DurandalCode/star-dome/docs/base-hub.md

# Base hub versions

The base hub (`BASE3-d`, `BASE2-d`) is the one connector that has been printed
and fitted. Its versions are numbered so a printed piece can be traced to the
geometry that made it. A version is a git tag. A version that has been
superseded is frozen, and is not updated
([0006](decisions/0006-a-superseded-design-is-frozen.md)).

| version | tag | stake | what it is |
|---|---|---|---|
| 1.0 | `base-hub-1.0` | steel angle | a stack of flat plates, one channel per level; a pad on the bottom plate and a printed wrap round the angle ([0025](decisions/0025-the-angle-is-met-on-a-pad.md)–[0029](decisions/0029-put-the-lower-stack-bolts-inside-the-base-plate.md)) |
| 1.1 | `base-hub-1.1` | rebar, 8–18 mm | 1.0 with the wrap replaced by a vee cradle on the same pad; the plates are identical ([0031](decisions/0031-the-stake-is-rebar-and-a-vee-takes-any-bar.md)) |
| 2.0 | — | rebar, 8–18 mm | one print: a tube per bow on a rib, a sleeve for the bar ([0032](decisions/0032-the-base-hub-is-one-print.md)); not yet printed |
| 2.0b | — | rebar, 8–18 mm | 2.0 with `ribs = 0`: bare tubes, printed on slicer tree supports. `BASE3-8` 69 cm³ against 2.0's 81; supports to break off, and no rib stiffening the arm. Printed side by side with 2.0 to choose |

`connectors/base_hub_v1.py` is 1.1, and stays 1.1. `connectors/base_hub_v2.py`
is 2.0, and is what the schedule builds.

## What the printed set is for

One `BASE3-8` is printed: plates from 1.0, which 1.1 left unchanged. Its rod
channels are drawn for an 8 mm rod with 1.4 mm of clearance, Ø9.4. In the
hand **a 10 mm composite rebar goes in and an 8 mm one rattles**. The printed
set is therefore a hub for 10 mm composite bows, whatever its name says.
Composite rebar is named by an equivalent diameter and measures differently
across its winding. Until that is measured, the channel says nothing about
the rod named on the part.

## What 1.x taught

The fit check found more than the channel:

- **The stack carries material nobody needs.** Each plate is the full outline
  of the hub. A rod occupies one level, but every other level is solid across
  the same footprint. Seen end on, a printed stack is a block with three holes
  in it.
- **The levels stay.** At a base point the three bows meet at one point in
  one plane ([`weave.base_fan`](../stardome/weave.py)), so the ends *could*
  share a level. They keep the node's levels anyway: a bow should be able to
  pass straight through the foot, and the hub should be able to take that
  bow, so the channels run out both sides. What goes is the material between
  them, not the levels.
- **Five prints per hub is too many** for 10 hubs a dome.
- **The cradle is a short grip**: 40 mm along the bar, and a loose piece to
  hold while two bolts are started.

2.0 starts from those four points.

## The ribs are thin

The rib under each tube is 1.6 mm, four lines of a 0.4 nozzle, rather than
1.5 walls. At 1.5 walls the ribs were about a quarter of the hub: `BASE3-8`
went from 97.5 cm³ to 80.6, `BASE3-10` from 121 to 98. Supports instead of
ribs would save a little more. But they have to be broken off every part,
PETG holds on to them, and the arm loses the stiffness across the fan that a
rib gives. A rib that tall and thin may wobble under the nozzle near its top;
that is one of the things the first print is for.

## 2.0 in the field

1. Drive the rebar.
2. Drop the two M8 nuts into the pockets in the sleeve's tunnel floor.
3. Lower the hub over the bar and do up the two M8 set bolts from below. The
   bolts push the bar into the vee, so any bar from 8 to 18 mm is held.
4. Push each bow end into its tube and pin it.

The bar stands above the foot, past the fan, for the cover's loops to drop
over.

## The ten feet are two prints

Five of the ten base points are the mirror of the other five. Since 2.0 they
take the hub's **mirror image** (`BASE3-8m`, `BASE2-8m`) rather than the hub
turned over, so the rebar sleeve is on the same side of the bundle at all
ten ([0033](decisions/0033-the-base-hub-has-a-mirror-image.md)). Four and
four of `BASE3`, one and one of `BASE2`. Hub 1.x is frozen and is still
turned over.
