DurandalCode/star-dome/docs/roadmap.md

# Дорожная карта

Карта намеренно построена «сначала прототип»: геометрию, сборку и поведение коннекторов нужно доказать на малых вариантах, прежде чем считать XL-варианты строимыми конструкциями.

## Этап 0 — Рабочее место и инструменты

**Цель:** воспроизводимый локальный процесс без платных CAD-сервисов.

- [x] Скелет репозитория.
- [x] Роли инструментов описаны: OpenSCAD / FreeCAD / Blender.
- [x] Инструкции для агентов в `AGENTS.md`.
- [x] Все три инструмента запускаются локально без GUI и управляются из `Makefile`: OpenSCAD 2021.01 (`make scad`), FreeCAD 1.1.3 через `freecadcmd` (`make clamps`), Blender 5.2.1 через `--background` (`make blender`, `make site`). Пути к бинарникам — переменные `OPENSCAD`, `FREECADCMD`, `BLENDER` в начале соответствующих секций `Makefile`.
- [ ] Описать локальную установку под macOS.

**Критерий завершения:** агент может создавать и править геометрию во всех трёх приложениях локально. **Выполнен** — через `Makefile`, а не через MCP.

Про MCP отдельно. Изначально этот этап требовал «подтвердить рабочую настройку MCP» для каждого из трёх приложений, но проект пошёл другим путём, и это оказалось правильным: MCP годится для интерактивного разглядывания, а всё, что должно быть воспроизводимым, запускается скриптом из репозитория. Правило записано в [`architecture.md`](architecture.md): если результат нельзя пересобрать одной командой из чистого клона — это не результат. Поэтому MCP здесь необязателен и в критерий завершения не входит.

## Этап 1 — Эталонная геометрия Star Dome

**Цель:** воспроизвести базовый Star Dome в духе Такэкавы как параметрическую модель.

- [x] Реализовать базовую топологию Star Dome в OpenSCAD.
- [x] Параметризовать диаметр купола и диаметр стержня.
- [x] Сначала получить эталонный вариант D6.
- [x] Определить и назвать дуги, опорные точки и точки пересечения.
- [x] Добавить простые геометрические проверки и производные размеры.
- [x] Получить исследовательские варианты D4, D8 и D12 из той же модели.

**Критерий завершения:** все именованные варианты получаются из одной исходной модели без ручной правки геометрии. **Выполнен.** См. [`dome/README.md`](../dome/README.md).

15 дуг раскладываются на три семейства по 5: семейство G с наклоном `atan(2)` (экваториальные десятиугольники икосододекаэдра, размечаются по пятым долям), семейства U и L с наклонами 79.1877° и 37.3774° (размечаются по третям). В итоге в каждой из 10 опорных точек сходятся 3 конца стержней, а связанных узлов по 4 стержня — 10. Группа симметрии D5.

Два результата важны для следующих этапов:

- **В каждом связанном перекрестье сходятся четыре стержня**, а не два. Коннектор этапа 3 обязан это выдержать, причём на трёх разных углах пересечения. Проверить по фотографиям и физическому макету до проектирования детали.
- **Каждая дуга согнута по радиусу, равному радиусу купола** (от 2000 мм для D4 до 6000 мм для D12), так что минимальный радиус изгиба — прямое ограничение на выбор стержня, а не примечание.

Инженерный отчёт по геометрии генерируется из той же модели скриптом `tools/export_geometry.py` в `exports/geometry/` (JSON + CSV): каждое пересечение стержней с координатами, касательными, углами, наклонами, признаком «сверху/снизу» и классом симметрии. Сам экспортёр геометрии не содержит — источник истины остаётся один.

Диаметры стержней в `configs/variants.toml` остаются предварительными инженерными допущениями. Ничего структурного не проверено.

## Этап 1.5 — Геометрическое ядро и контракт данных

**Цель:** дать этапам 2 и 3 машиночитаемые данные и вынести геометрию туда, где её можно покрыть юнит-тестами.

- [x] Перенести геометрию в Python-пакет без зависимостей, `stardome/`.
- [x] Перенести конфигурацию вариантов в `configs/variants.toml`.
- [x] Выдавать схему `star_dome_geometry/1` как `model.json` плюс плоские CSV-представления.
- [x] Превратить таблицу проверок из `dome/README.md` в исполняемые инварианты (`stardome verify`).
- [x] Закоммитить по одному компактному эталонному срезу на вариант в `tests/golden/`.
- [x] Сверить Python- и OpenSCAD-производители поле за полем.
- [x] Заморозить `dome/star_dome.scad` как эталонную реализацию и гонять сверку в CI на каждом пуше.
- [x] Добавить сборщик сцены `blender/`, читающий `model.json`.
- [x] Добавить генератор зажимов для FreeCAD, читающий `crossing_types`.
- [x] Убрать `configs/variants.scad` в пользу `configs/variants.toml` или генерировать один из другого. Генерируется командой `python3 -m stardome scad-config`, CI падает при любом расхождении — см. `.github/workflows/check.yml`, шаг «Generated config is up to date». `variants.toml` — единственное место, где определяется вариант.

**Критерий завершения:** каждый инструмент ниже по течению читает геометрию из `model.json` и никто её не пересчитывает. **Выполнен.** OpenSCAD, FreeCAD и Blender потребляют сгенерированную модель; никто из них геометрию не пересчитывает.

`dome/star_dome.scad` намеренно продолжает считать свою геометрию сам: в этой независимости и есть вся ценность перекрёстной сверки. Он заморожен, а не превращён в потребителя данных, поэтому базовая топология остаётся под постоянной проверкой двумя реализациями, а вся новая работа идёт только в `stardome/`. См. [`architecture.md`](architecture.md), раздел про политику эталонной реализации.

Зачем этот этап нужен: геометрия здесь аналитическая, а то, что реально требуется этапам 2 и 3 — идентификаторы узлов, касательные, углы пересечения, классы симметрии, выгруженные в JSON, — это ровно то, чего OpenSCAD не умеет без слоя выскребания текста. Два потребителя из трёх и так на Python. См. [`architecture.md`](architecture.md).

Оба производителя совпадают точно на всех вариантах по каждому стержню, узлу, пересечению и полю `meta`. Единственное намеренное расхождение — `crossing_types.family_a`/`family_b` в двух классах L/U, где подписи OpenSCAD-экспортёра и его же колонки углов относятся к разным стержням; вывод Python самосогласован. Генерация коннекторов читает именно эти поля, так что это существенно.

## Этап 2 — Интеграция с Blender и композиция в человеческом масштабе

**Цель:** использовать реальную сгенерированную геометрию для пространственного планирования.

- [x] Выгрузить/загрузить сгенерированную геометрию купола в Blender в масштабе 1:1. `blender/build_scene.py`, `make blender`.
- [x] Сохранить опознаваемость отдельных дуг и пересечений. Объекты несут свои идентификаторы из модели и разложены по коллекциям под роль.
- [x] Добавить переиспользуемые фигуры человеческого масштаба. Фигура 1.75 м, поставлена внутри купола.
- [x] Добавить базовое представление тканевой обшивки. `stardome/cover.py`, `make covers`, см. [`cover.md`](cover.md). Ткань лежит не на номинальной сфере, а на внешней поверхности самого дальнего стержня плетения: у D6 это 3020 мм против 3000, то есть **+1.3% площади**. Плюс раскрой на полотнища: D6 — 13 штук 1460 × 4744 мм на рулоне 1500, 61.7 м швов. Радиус — замкнутая форма `r + 2d`: стопка из четырёх стержней высотой в три диаметра, внешний сидит на 1.5 от номинала, ткань обходит его поверхность ещё на полдиаметра. До 12 сентября здесь стояло 3075 — число из «слоёной» условности, которая разносит 15 дуг по четырнадцати диаметрам, тогда как настоящее плетение укладывается в три. Это было **3.7% лишней ткани на M**.
- [x] Построить процесс проверки габарита входа. `stardome/entrance.py`, `make entrances`, см. [`entrance.md`](entrance.md). Считается, а не прикидывается на глаз: купол разворачивается в координаты «азимут × высота», и наибольший пустой прямоугольник решается точно.
- [x] Построить простой генератор/размещение крытого коридора. `stardome/corridor.py`, `make corridors`, см. [`corridor.md`](corridor.md). Дуговой тоннель на выбранном пролёте, с проверкой того, что все пропускают мимо ушей: **проходит ли коридор в тот проём, к которому пристроен**. Сечение проверяется тем же `doorway.fit_shape`, что и силуэт человека, — одно определение «проходит» на весь проект.
- [x] **Лагерь: купола, соединённые коридорами, по плану из конфига.** `configs/camps.toml`, `stardome/camp.py`, `make camp`, решение 0018, см. [`camp.md`](camp.md). До этого «лагерь» был шеренгой размеров — ни один купол ни с чем не был соединён. План говорит только, какие купола где стоят, насколько повёрнуты и что с чем связано; азимут на соседа, нужная дверь, длина коридора и оба устья выводятся. Дверь наводится **поворотом купола**, а не новым проёмом: купол — жёсткая вещь, которую ставят под углом, а проём стоит прутка и деталей. Чего поворот не может — направить одну дверь на двух соседей; купол в середине лагеря требует двери на соседа, и план об этом сообщает. Дверей и разворота никто не пишет: купол, соединённый с тремя, получает три двери, направленные на этих троих (решение 0019). И там же вылезло ограничение, про которое никто не говорил вслух: **дверь стоит в пролёте, а их пять через 72°**, поэтому азимут и обратный ему (разница 180°, не кратная 72) не могут оба попасть на двери у двух одинаково поставленных куполов. Один из пары приходится развернуть на 36° — и выведенные развороты сами ложатся чередованием 0/36 вдоль каждого коридора. Поставляемый `tree` — семь куполов, шесть коридоров, все шесть садятся точно на двери с обоих концов.
- [x] Создать композиционную сцену с несколькими экземплярами. `blender/build_site.py`, `make site` для всех шести вариантов и `make sizes` для четырёх именованных — каждый развёрнут дверным проёмом к камере, с фигурой 1.75 м в этом проёме.
- [x] Дверей у купола может быть несколько, и каждая смотрит куда сказано. `[[variants.X.doors]]` в `configs/variants.toml`, решение 0016. Направление задаётся азимутом и является пожеланием: дверь может стоять только в пролёте, их десять, и подходящие зависят от реза — портал в низком, всё остальное в высоком. Двери не независимы: рез убирает пруток из габаритной огибающей по всему куполу, поэтому каждый проём меряется уже на куполе со всеми резами. Старая пара `door`/`door_cut` продолжает означать одну дверь и даёт побайтово тот же результат.
- [x] Выбрать и отрисовать сам дверной проём. `stardome/doorway.py`, `make doorways`, см. [`doorway.md`](doorway.md). Не просто «дверь куда-то влезает», а какой пролёт, какими стержнями и каким узлом он обрамлён, выгруженный замкнутым 3D-контуром, который рисуют сборщики сцены.

**Критерий завершения:** входы и коридоры можно расположить относительно реальной раскладки стержней и осмотреть с высоты человеческих глаз.

**И результат по интерьеру меняет то, какой вариант строить.** Комнату определяет не диаметр и не высота в коньке, а **сколько квадратных метров пола, на которых можно встать в полный рост**, — и голый купол тратит большую их часть впустую: у D4 12.6 м² пола и 2.4 м², где можно выпрямиться, то есть 19%. Юбка — самое дешёвое лекарство с большим отрывом: D3 на метровой юбке даёт больше чем вдвое больше места в рост, чем голый D4, на меньшем пятне и меньшем метраже стержня. Вся цена — ветер: индекс опрокидывания 0.424 для голого купола любого размера и растёт до 0.74 у D3 с метровой юбкой. **D6 + 760 мм юбки** поднимает долю полезного пола с 64% до 88%, и на тот момент это выглядело как ответ для эталонного прототипа. Дверной проём ниже это отменил: юбка перестала быть нужна для входа, осталась только ради площади, и M строится голым. См. [`interior.md`](interior.md).

**Результат по входу меняет вопрос о размере.** Самое высокое место без препятствий у опорного кольца — 0.2549 × диаметр, и доля одна и та же для любого варианта, потому что топология фиксирована. Значит, двери в рост не существует ниже D10: лучший проём D6 — 497 мм шириной на высоте 1200 мм, а у D3 и D4 проёма высотой 1200 мм нет вообще. Двери 1800 × 700 мм нужно 760 мм юбки на D6, 1320 мм на D4 и 1600 мм на D3 — что для D3 означает конструкцию 3.07 м над пятном 3 м. По прямоугольнику выходило, что D6 просит юбку, а D3 — вход ползком или другой размер. См. [`entrance.md`](entrance.md).

**А результат по дверному проёму снова всё смягчает.** Те цифры вписывают *прямоугольник*, а ни человек, ни проём прямоугольником не являются. Каждый из пяти высоких пролётов — стрельчатая арка: две дуги G, сходящиеся в связанном четырёхстержневом узле, с опорами в двух опорных точках. Вписать силуэт формы человека в отверстие формы человека дешевле, чем говорил прямоугольник: 1240 мм на D4 вместо 1320, 700 на D6 вместо 760, 190 на D8 и ноль на D10. Проём не стоит ничего — ни реза стержня, ни выдуманного соединения, — и таких пролётов пять. См. [`doorway.md`](doorway.md).

**И наконец портал отменяет остаток вопроса.** Дверь уехала из высокого пролёта в низкий — два U и одна почти горизонтальная L сверху, — и туда она встаёт за 2.8% стержня, не перерезав ни одной дуги. После этого юбка для входа не нужна нигде.

**Размеры устоялись как S = D4 + 1350 мм, M = D6 без юбки, L = D8 без юбки, XL = D10 без юбки, XXL = D12 без юбки.** Все кроме S голые по выбору, и юбка у S стоит не ради двери, а ради площади пола. Входят все:

| | просвет | пропускает |
|---|---|---|
| S | 1210 мм над юбкой | всё, включая персонажа 2.2 м |
| M | 1816 мм | с ношей, но не 800 мм в ширину и не 2.2 м в рост |
| L | 2423 мм | всё, включая персонажа 2.2 м |
| XL | 3029 мм | всё, с запасом |
| XXL | 3636 мм | всё, с запасом |

**Имя размера говорит, что выбрана сборка, а не что стержень проверен под нагрузкой.** Ни один размер в этой семье под нагрузкой не считался: `stardome span` сравнивает купола друг с другом и принимает пригодность эталона как данность — это этапы 3 и 8. Громче всего это допущение звучит на XXL: равный прогиб на пролёте 6283 мм просит 40 мм стержня против заложенных 12. Поэтому `note` у D12 это и говорит, и он единственный, кому приходится.

**M — единственный из построенных размеров, который кому-то отказывает.** Поле `door` в конфиге фиксирует, что купол реально пропускает, а не что хотелось бы, и модель перечисляет каждый силуэт, который проходит.

## Этап 3 — Первый печатный коннектор перекрестья

**Цель:** заменить верёвку/вязку в характерном перекрестье быстрым переиспользуемым печатным коннектором.

- [x] Выбрать эталонные диаметры стеклопластикового стержня, изначально 8 и/или 10 мм. Зафиксировано в `configs/variants.toml`: 8 мм для D3/D4, 10 мм для D6/D8, 12 мм для D10/D12; эталонный прототип D6 — 10 мм. Это выбор, а не измерение: подтверждение по реальному прутку — следующий пункт, и он открыт.
- [ ] Измерить реальный допуск стержня и поведение поверхности. **Модель к этому готова.** В РФ самый вероятный пруток — композитная стеклопластиковая арматура (ГОСТ 31938), бухтами по 50 м, ~42 ₽/м. Она названа по **эквивалентному** диаметру, а несёт навивку, которая стоит выше него: канал, прорезанный по имени, стержень не примет. Поэтому одно число разделено на два — `rod_diameter` остаётся стержнем как **несущим элементом** (от него болт, длина муфты, оценка изгиба), а `rod_outer_diameter` описывает стержень как **предмет, который должен пролезть** (каналы, контакт стержня о стержень в узле, радиальный шаг плетения, габарит проёма, сфера, на которой лежит ткань). По умолчанию ноль — значит, совпадают. Останется подставить замеренное.

  Чувствительность посчитана: при наружном от 10 до 12 мм плетение решается всюду, ткань растёт на 0.2%, высота стопки узла — на 15%, габарит зажима — на 2 мм. **Геометрия устойчива; ломается только посадка.** Заодно бухта мотается на диаметр 1.2 м при нужных дуге 3 м радиуса — первое подтверждение со стороны материала, что радиус изгиба не проблема.
- [x] Спроектировать зажим перекрестья во FreeCAD. V1, двухсоставный на болтах, см. [`crossing-clamp-v1.md`](crossing-clamp-v1.md).
- [x] Избежать острых кромок контакта и точечной нагрузки на стеклопластик. Раструбы на входах, сёдла 180°; контакт «стержень по стержню» в перекрестье ещё предстоит подтвердить.
- [x] Сделать параметрическими зазор, диаметр стержня, толщину стенки и размеры крепежа. Варианты 8/10/12 мм получаются из одного набора параметров.
- [ ] Напечатать и проверить многократную сборку-разборку. **Появилось что проверять помимо самой печати.** У зажима теперь два варианта закрытия — `fastenerStyle`, решение 0020, см. [`quick-release.md`](quick-release.md): болтовой V1 без изменений и навесной, где крышка сидит на стальном штифте в плоскости разъёма, а болт остаётся один и стоит в пазу, открытом наружу. Купол M просит **84 болта в поле**, а в мастерской с хабом 2.0 не остаётся ни одного, и навесной вариант убирает из полевых 32. Чего никто не мерил: держит ли один болт то, что держали два (второй узел теперь работает на срез штифта, а не на растяжение болта), и сколько циклов выдержит печатная проушина — 2.85 мм материала вокруг отверстия. Оба вопроса — на стенд, и до ответа умолчанием остаётся болтовой.
- [ ] Зафиксировать режимы отказа и переделать.
- [x] Согласовать зажим со сгенерированной геометрией перекрестья. `connectors/generate_clamps.py` читает расписание, которое `stardome` выводит из модели, и строит каждую деталь на её настоящем угле пересечения и диаметре стержня — он не считает никакой геометрии купола сам.

**Геометрические ограничения, которым обязан соответствовать коннектор.** Из модели этапа 1:

- Точек пересечения **40**, а не 20: 10, где через одну точку проходят **четыре** стержня, и 30, где два. Зажим V1 — деталь на два стержня.
- Контактов «стержень-стержень» **90**, в **12 симметрично различных геометриях**, на **пяти разных углах пересечения**: 37.3774, 41.8103, 63.4349, 70.5288 и 79.1877°. Деталь, предполагающая один угол, не подойдёт.
- 60 связанных контактов используют четыре из этих углов; все 30 несвязанных — на 70.5288° = `acos(1/3)`.
- Наклон стержня в перекрестье меняется от 4.7 до 65.4° над горизонтом, так что зажим не может рассчитывать, что пара стержней лежит в удобной плоскости.

**Четырёхстержневой узел подтверждён.** Это была реконструкция; теперь она сверена с монтажной схемой самого первоисточника. На панели 1 обвязаны 5 стыков синей пентаграммы, в каждом пересекаются две синие дуги; на панели 2 добавлены зелёные дуги, и те же 5 обвязок держат две синие плюс две зелёные. Четыре стержня, в том рисунке, который предсказывает модель. См. [`tied-node.md`](tied-node.md) и [`references.md`](references.md).

Но два момента тот же источник меняет:

- Первоисточник **вяжет эти стыки попарно**, двумя-тремя стяжками, собранными на коротком участке, а не как один пучок из четырёх стержней. Жёсткая веерная деталь — отход от его практики, так что короткая стопка двухстержневых зажимов остаётся законной альтернативой, и притом сохраняющей одно семейство деталей.
- В бамбуковой модели обвязок **намного больше, чем десять размеченных**. То есть авторитет первоисточника не даёт оснований отказаться от 30 двухстержневых зажимов; это решение за прототипом D4.

**Что говорит расписание коннекторов.** `python3 -m stardome connectors D6` раскладывает каждое пересечение по детали, которая его обслужит. На сегодня для D6 это шесть типов деталей, 107 штук на купол:

| деталь | шт. | генератор |
|---|---|---|
| `FAN4-10-37.3774` — веер на 4 стержня | 10 | `fan_node_v2` |
| `CL2-10-70.5288` — зажим на 2 стержня | 30 | `crossing_clamp_v1`, в двух зеркальных исполнениях 17/13 |
| `BASE3-10` — опорный хаб на 3 конца | 8 | `base_hub_v2` |
| `STAKE-BASE` — забивная стальная арматура | 10 | железка, её надо выбрать, а не проектировать |
| `BASE2-10` — пятка косяка, 2 конца дуги | 2 | `base_hub_v2` |
| `TERM-10-70.5288` — окончание разрезанной дуги | 2 | `term_clamp_v1` |
| `SPLICE-10` — стык дуги по длине | 45 | `rod_splice_v1` |

**97 деталей из 107 генерируются, 10 — покупная железка, недостающих нет.** Пробел закрыт. Осталась одна вещь, и она не деталь: забивной стальной уголок надо выбрать по размеру, а не спроектировать.

Три исправления всплыли только тогда, когда деталь впервые попробовали поставить на купол (`make assembly`):

- **Опоры по краям проёма держат два конца дуги, а не три.** Разрез портала снимает `L1` с `b0` и `L4` с `b1` — ровно с тех двух опор, между которыми стоит дверь. Расписание по-прежнему просило десять одинаковых трёхлучевых хабов. Теперь просит восемь плюс два `BASE2`: те же дуги U и G, зазор 37.3774° в обоих случаях, зеркальная пара — то есть одна печать. Ни в расписании, ни здесь этого раньше не было.
- **Веер резался не по тому лучу.** Порядок лучей брался сортировкой по углу, а первым считался наименьший. У пяти нижних узлов при этом самый широкий зазор попадает в **середину** стопки, и они требуют каналов с шагом 37.3774, 63.4349, 37.3774°, тогда как у напечатанной детали шаг 37.3774, 41.8103, 37.3774°. Десять узлов, две детали — при том что проект всегда утверждал, что деталь одна. Разрез по самому широкому зазору делает утверждение верным, и решённая намотка на нём остаётся допустимой.
- **Двухстержневой зажим — хиральная деталь.** Крышка идёт снаружи, поверх стержня, который идёт снаружи, поэтому перевернуть её, чтобы сошлись углы, нельзя: 17 перекрестий берут деталь как нарисована, 13 — её зеркало. Это вторая печать, которую никто не считал.

- [ ] Решить, нужны ли 30 несвязанным пересечениям зажимы вообще, или усилия целиком принадлежат четырёхстержневым узлам. **Цена вопроса посчитана: 5/3 по пролёту и 2.78× по диаметру прутка** (`make spans`, см. [`span.md`](span.md)). Без зажимов дуга держится только за пятки и метки, и наибольший пролёт в куполе — 60° на семействах U и L; с зажимами он падает до 36° на G, а U и L уходят на 22.24°. Семейство G не выигрывает ничего: все четыре его пересечения и так связанные узлы. Решение по-прежнему за образцами, но теперь известно, чем платить за «нет».
- [x] Выбрать радиальный порядок укладки в четырёхстержневом узле. **Веерный порядок, 1-2-3-4.** См. [`tied-node.md`](tied-node.md).
- [x] Проверить, согласуется ли одно глобальное назначение «сверху/снизу» на всех 90 контактах сразу. **Согласуется**, для любого порядка укладки, и не требует радиального места сверх собственной высоты стопки.
- [x] Спроектировать веерный коннектор на четыре стержня. **V2** в `connectors/fan_node_v2.py`, см. [`fan-node-v2.md`](fan-node-v2.md): стопка из пяти плит, каждый стержень в настоящем канале, контакта «стержень по стержню» нет. Шаг стопки 10.00 мм: стержни опираются друг на друга в перекрестье, а каждая плита — крест с отверстием посередине, так что стопка ровно такой же высоты, как у V1, но каждый стержень лежит в канале. Все пять печатаются без поддержек. V1 ([`fan-node-v1.md`](fan-node-v1.md)) зажимал стержни пучком и средние два не фиксировал вовсе; оставлен как запись. В пластике ничего не проверено.
- [ ] Выбрать между веерной деталью и стопкой двухстержневых зажимов — по напечатанным образцам.

**Четырёхстержневой узел оказался лёгким случаем.** Все четыре стержня в связанном узле компланарны — касательная к большой окружности лежит в касательной плоскости сферы, — так что узел это плоский четырёхлучевой веер со стержнями, уложенными по радиусу, а не трёхмерный клубок. Все десять узлов — один и тот же веер: зазоры 37.3774, 41.8103, 37.3774 и 63.4349°, в сумме 180. Пять верхних узлов читаются как G-U-U-G, пять нижних как L-G-G-L, но геометрически это одна форма.

Значит, всему куполу нужны **две геометрии коннектора**: один веер на четыре стержня (10 шт.) и один зажим на два (30 шт., и необязательный). Не двенадцать.

Порядок укладки выбран веерный, 1-2-3-4: он выводит три самых пологих угла в контакт «стержень по стержню», требует двух различных углов седла вместо трёх, палиндромен и формулируется в поле одной фразой. Его цена в том, что стержни G и L меняют уровень между узлами, что выражается уклоном 1.6% — не ограничение. Высота стопки — три диаметра стержня.

**Плетение сходится.** Если вести стержни прямо между их смещениями в связанных узлах, 15 из 30 несвязанных пересечений начинают проникать друг в друга, то есть наивный ответ неверен, — но согласованный маршрут существует, для любого порядка укладки, и он остаётся внутри радиальной полосы, которую и так занимает четырёхстержневая стопка (±1.5 диаметра стержня). Стержень сходит со своей большой окружности примерно на градус. С ростом купола плетение становится проще, так что **тесный случай — D4, а не D12**.

Одно следствие для детали: стержень приходит в узел с радиальным наклоном до ~1.2°, вообще говоря разным с каждой стороны, так что канал, просверленный строго по касательной, создаст в нём предварительное напряжение.

**Критерий завершения:** один коннектор можно многократно собирать в поле, не повреждая стержень и не требуя возни с крепежом.

## Этап 4 — Физический прототип D4/D6

**Цель:** проверить базовую систему до масштабирования вверх.

- [ ] Собрать частичный полноразмерный макет звезды/перекрестья.
- [ ] Собрать полный каркас D4 или D6.
- [ ] Замерить время сборки и размер бригады.
- [ ] Проверить повторяемость формы и подвижность коннекторов под нагрузкой.
- [ ] Проверить посадку обшивки и размещение входа.
- [ ] Проверить концепцию удержания/анкеровки основания в контролируемых условиях.
- [ ] Вернуть измеренную геометрию и найденные проблемы обратно в CAD.

**Критерий завершения:** малый/эталонный купол собирается, накрывается, разбирается и пересобирается предсказуемо.

**Бюджет допусков посчитан, и он меняет способ разметки, а не аккуратность.** Измеряется во всей конструкции ровно три вещи: 10 колышков, 15 длин и 40 меток — остальные 30 пересечений не размечает никто, они ложатся туда, куда их выводит плетение. См. [`tolerance.md`](tolerance.md) и `python3 -m stardome tolerance D6`.

- **Форма ошибку гасит, а не усиливает.** Две точные производные, не зависящие от размера купола: подъём дуги меняется на **+1/2** мм на миллиметр длины стержня и на **−(π/4 − ½) = −0.2854** мм на миллиметр диаметра основания. Обе по модулю меньше единицы.
- **Общая ошибка бесплатна; платят только расхождения.** Если все дуги длиннее на 10 мм и кольцо шире на 10 мм, купол просто получается другим и сходится сам с собой — метки берутся долями от собственной длины стержня. Смотреть надо не на высоту, а на **разброс в узле**: насколько разошлись четыре метки, которые должны были совпасть.
- **Вопрос не в том, каков разброс, а в том, чем его мерить.** Разброс `s`, натянутый на пролёт `a`, гнёт стержень по параболе с кривизной `2s/a²`; стержень и так согнут по радиусу купола, поэтому честная мера — доля от той кривизны, которую он уже держит. Чистая геометрия, без модуля и прочности. Пролёт берётся из схемы разметки: стержень удерживается на ногах и на метках и больше нигде — 30 несвязанных пересечений не зажимы. Пятые доли семейства G дают самый тесный пролёт и задают допуск.
- **Держать нужно порядка одной 215-й радиуса, и этого достигает рулетка.** ±7 мм на D3, ±14 мм на D6, ±27 мм на D12 для колышков и меток; на длине реза вдвое свободнее. Допуск **пропорционален куполу**, а не абсолютен: допустимый разброс это `бюджет × пролёт² / 2R`, а пролёт растёт вместе с R. Все размеры одинаково требовательны в относительных единицах.
- **Небрежная сборка проходит.** Рулетка по траве без особой аккуратности (сигмы 10/3/3 мм) даёт медианный разброс в узле 32 мм, то есть **5.4% добавки к кривизне**, 7.5% на p95 и около 10% в худшем прогоне из двух тысяч.

Практический итог: **шаблон не нужен, рулетки достаточно.** Единственное правило, которое стоит соблюдать, потому что оно бесплатное: **все метки отмерять от одного конца стержня** — разметка «от предыдущей» стоит на 54% больше разброса при той же аккуратности, так как четвёртая метка дуги G несёт четыре ошибки вместо одной.

Оговорка, которая здесь важнее вывода: `2s/a²` считает соседние узлы жёсткими, то есть это верхняя оценка, а «10% добавочной кривизны» — выбранный бюджет, а не предел. Где предел на самом деле, скажет прочность реального прутка. Это ровно тот открытый пункт этапа 3, который ни от чего не зависит, и теперь он упирается ещё и сюда.

**Порядок сборки посчитан заранее, и ни одного пункта выше он не закрывает** — все они про физику. Но идти в поле, не зная, в каком порядке ставить дуги, больше не нужно. Плетение — это орграф на 15 вершинах с 90 дугами «внутренний → внешний», порядок сборки — его линейное упорядочение, а цена порядка — число дуг, направленных назад, то есть минимальное разрезающее множество дуг. При 15 вершинах оно решается точно. См. [`assembly.md`](assembly.md) и `python3 -m stardome assembly D6`.

Три результата меняют то, как планировать этап:

- **Сборки без протаскиваний не существует.** Плетение циклично: G1 внутри G5, G5 внутри U1, U1 внутри G1. Три дуги, каждая внутри следующей, в линию не выстраиваются. Это не дефект — ациклическое плетение было бы стопкой обручей, которую ничто не держит.
- **Минимум — 20 протаскиваний из 90 пересечений, и он одинаков для всех вариантов.** Орграф задаётся топологией и порядком укладки в узле, а они не масштабируются. **D3 и D12 — это одна и та же сборка**; с размером меняется длина и вес того, что пружинишь, а не сколько раз. Так что малые варианты не «те, которые проще поставить».
- **18 из 20 куплены в десяти связанных узлах.** Веерный порядок ориентирует 60 дуг из 90 ещё до всякого плетения, и одни они уже стоят 18. Значит, маршрут 30 свободных пересечений почти ничего не стоит, а дешевле собрать можно только через другой порядок укладки — см. `weave.stacking_options`.

Для поля важно ещё одно: порядок «по семействам», который единственный можно произнести вслух, стоит 30 против 20, и делится ровно одним правилом — **семейство L поднимать раньше U**. Где идёт G, не имеет значения. Стоят ли 10 лишних протаскиваний того, чтобы не сверяться со списком из 15 пунктов, решает секундомер этого этапа, а не геометрия.

## Этап 5 — Семейство коннекторов и интерфейсы

**Цель:** сохранить простоту полевой сборки при полноценной временной конструкции.

- [x] Опорный/грунтовый коннектор. `connectors/base_hub_v1.py`, см. расписание выше (`BASE3-10`): плоский веер из трёх лучей, арматура прижимается к площадке отдельным ложементом с V-пазом, который берёт любой пруток от 8 до 18 мм ([решение 0031](decisions/0031-the-stake-is-rebar-and-a-vee-takes-any-bar.md)); четыре болта стягивают стопку плит. Спроектирован и генерируется из модели. Первый `BASE3-8` напечатан: в канал входит композитная арматура 10, а 8 болтается — записано в [`printing.md`](printing.md), пока не исправлено. Версии хаба — [`base-hub.md`](base-hub.md): 1.0 под уголок, 1.1 под арматуру, напечатанный комплект фактически под композитную арматуру 10. **2.0** (`connectors/base_hub_v2.py`, [решение 0032](decisions/0032-the-base-hub-is-one-print.md)) — одна печать вместо пяти: трубка на ребре под каждую дугу на прежних уровнях, гильза 80 мм под арматуру 8–18 мм, без стяжных болтов; `BASE3-8` — 98 см³ вместо 222. Ещё не напечатан.
- [x] Семейство перекрёстных коннекторов под выбранные размеры стержня. Две геометрии — веер на четыре стержня и зажим на два, — обе параметрические по 8/10/12 мм из одного набора параметров. Спроектированы и генерируются; **в пластике не проверены**.
- [x] Соединения юбки. `connectors/skirt_collar_v1.py`, решение 0017, см. [`skirt.md`](skirt.md). Раньше расписание читало опорную точку с юбкой как **восемь членов** — три конца дуг, голова стойки, две хорды кольца и две головы раскосов, — и это был самый нагруженный узел конструкции без единой детали. Ничего из этого не обязано было быть правдой: у хаба уже есть площадка и болт под забивной уголок (до решения 0025 — сквозной паз), а **стойка юбки — это тот же уголок, только длиннее**. Значит купол с юбкой берёт ровно тот же `BASE3`, что и голый, а собственные члены юбки садятся на хомут, зажатый на стойке. У верха и низа стойки хомут один и тот же: хорды уходят горизонтально на обоих концах, раскосы — под одним углом, вниз у головы и вверх у пятки, так что перевёрнутая через наружный радиус головная деталь и есть пяточная. Одна геометрия, 20 штук на купол. Типов деталей без чертежа стало 1 вместо 3.
- [ ] Крепление пояса/растянутого элемента.
- [x] Крепление обшивки, не концентрирующее нагрузку на одной печатной детали. `stardome/attachment.py`, `make attachment`. Способ удовлетворить требование оказался не «лучше проушина», а **никакой проушины**: обшивка садится на те же забитые уголки, на которых стоит сам купол — единственное, чья работа и так держать конструкцию от подъёма. Три части: болт-роуп в подрубке по всей кромке основания (линия в кулиске, а не ряд люверсов — ткань рвётся от точки и не рвётся от линии), десять петель по опорам, и пять лент через макушку по дугам семейства U. Ленту по дуге не надо никуда крепить отдельно: дуга и так идёт от опоры до опоры. Все три семейства касаются каждой опоры ровно по разу, а U — единственное, что доходит до верха (2947 мм против 2683 у G и 1821 у L). Итого на M: 17.2 м троса, 50.4 м ленты, 10 анкеров, **ноль печатных деталей**. См. [решение 0014](decisions/0014-the-cover-hangs-on-the-stakes.md). Нагрузку никто не считал — это этап 8.
- [ ] Интерфейсный коннектор входа/коридора. Стало нужнее: у купола теперь может быть несколько дверей в разные стороны, и коридор цепляется к первой из них.
- [x] Крепёж выводится из прутка, а не стоит константой. `connectors/kit.py`, `FASTENERS` и `scale_to_rod`: болт — половина диаметра прутка, округлённая до ближайшего из M3/M4/M5/M6/M8, стенка `0.4 × пруток` с полом 3 мм, поперечный штифт `0.4 × пруток` по стандартным размерам. Раньше везде стоял M5 независимо от прутка, из-за чего зажим выходил **8.1 × прутка** на 6 мм и **3.8 ×** на 16 мм, а опорный хаб был 113 мм поперёк при любом диаметре вообще. Теперь зажим 5.3 ×, веер 6.4 × на 10, 12 и 16 мм. Правило подобрано так, чтобы на 10 мм получался M5: **все 17 печатных деталей M не сдвинулись ни на микрон**, изменились только 8- и 12-мм. Это соглашение, а не расчёт — силу здесь никто не считает. См. [решение 0013](decisions/0013-the-bolt-is-half-the-rod.md).
- [ ] Перемычка над дверью (`HDR`) — единственная позиция в любом расписании, за которой не стоит ничего. Зажимает перемычку к дуге посередине пролёта, где нет пересечения, и уносит обруч верхнего кольца в обход проёма.
- [ ] Система маркировки или ключей для полевой сборки. Заготовка есть: у деталей осмысленные идентификаторы (`FAN4-10-37.3774`, `CL2-10-70.5288`, `BASE3-10`), а плиты стопки названы по позиции (`Bottom`, `Mid1`, `Mid2`, `Mid3`, `Cap`). Чего нет — физической маркировки на детали и защиты от сборки не в том порядке.
- [x] Стык дуги по длине (`SPLICE`, 45 шт. на D6). `connectors/rod_splice_v2.py` — **ферула**: трубка, в которую секции вдвигаются с двух концов, как в палаточной дуге. Стык — единственное соединение в куполе, которому не надо смыкаться вокруг чего-либо, потому что до сборки секции это два отдельных предмета. Длина 10 диаметров стержня, по 5 на сторону; держат два поперечных штифта, болтов нет. Прямая, а не гнутая: пруток на сборке ещё прямой, гнут его уже с надетой ферулой. **Середина расточена**, иначе жёсткая трубка длиной 100 мм заставила бы дугу выпрямиться на своей длине; так она опирается на два конца, а дуга изгибается внутри неё. Места стыков считает `stardome`, и считает их **на весь купол сразу**: купол режется не более чем на **две длины** — раскладка подбирается так, чтобы ни одна секция не была длиннее транспортной, ни один стык не сел на перекрестье, а в мешке лежало два типоразмера, а не четыре (на D12 — семь). M и XL от этого не сдвинулись, S и L стоили нуля лишних стыков. См. [решение 0024](decisions/0024-a-dome-is-cut-into-two-lengths.md).

  Цена ошибки, которую это исправило: V1 была двухсоставным зажимом на болтах — архитектура зажима перекрестья, скопированная туда, где она не нужна. Вышло 48.4 мм в ширину на 10-мм стержень, **3.54 л пластика и 180 болтов M5 на купол** против 0.74 л и нуля. `rod_splice_v1.py` заморожен как запись.

  **В пластике не проверено, и держит ли оно изгиб — вопрос стенда.** Отдельно: для FDM это плохая деталь — печатать стоймя значит положить слои поперёк оси, то есть ровно в ту плоскость, которую изгиб и раскрывает. Ферула — первый кандидат на то, чтобы её **купить**: 45 штук это 4.5 м трубки Ø18×4.
- [x] Окончание разрезанной дуги (`TERM`, 2 шт.). `connectors/term_clamp_v1.py`: это зажим перекрестья с одним закрытым каналом, собранный поверх `crossing_clamp_v1`, а не второй такой же файл. Узлы `N26` и `N25` на M, оба под 70.5288°. **Это единственное место в куполе, где нагрузка приходит вдоль стержня в печатный пластик** — торец дуги упирается в стенку 5 мм. Хватает ли её — вопрос стенда.
- [x] Пятка косяка (`BASE2`, 2 шт.). Тот же генератор опорного хаба с одним лучом меньше.

**Критерий завершения:** конструкции хватает небольшого понятного семейства повторяющихся печатных деталей. **Выполнен геометрически:** шесть типов, 97 деталей на купол M, плюс десять покупных прутков арматуры. Не выполнен физически: в пластике не проверено ничего.

## Этап 6 — Большой вариант D8

**Цель:** нащупать практический верхний предел почти классической системы Star Dome.

- [ ] Выбрать размер стержня/трубы по измеренному поведению прототипа, а не простым геометрическим масштабированием. **Первая проверка нынешних значений сделана, и она их не подтверждает.** `configs/variants.toml` прямо называет свои диаметры допущениями; подобие просит `d ~ R`, а начиная с D8 каждый вариант тоньше этого: D8 несёт 10 мм там, где подобие просит 13.3, D12 — 12 мм против 20. По прогибу между опорами D12 в 11 раз слабее D6, из которого выведен.

  **Вторая проверка, уже с материалом, говорит обратное — и это не противоречие.** По допускаемой деформации гибки (`strength.md`) запас, наоборот, растёт с куполом: 0.45 на D12 против 1.19 на D3. Две проверки отвечают на разные вопросы. Подобие спрашивает «одинаково ли прогибается» и наказывает тонкий пруток на большом куполе; ползучесть спрашивает «переживёт ли пруток то, что его согнули» и наказывает толстый пруток на малом радиусе. Первое — про жёсткость, второе — про то, сломается ли бар. Выбирать диаметр придётся между ними, и D8 остаётся тем местом, где обе сходятся: 8.1 м — потолок семейства по паритету собственного веса при настоящей допускаемой деформации.
- [x] Проанализировать свободные пролёты. `stardome/span.py`, `make spans`, см. [`span.md`](span.md). Наибольший пролёт — **1.0472 R**, то есть 60° дуги, одинаково на каждом варианте: топология подобна себе в любом размере, поэтому пролёт это свойство не диаметра, а решётки. На D8 это 4189 мм, на D12 — 6283. Деформации остаются: по подобию считается **отношение** прогиба к эталонному D6 (неизвестная константа перед `w a⁴/EI` одинакова у двух домов одной формы и сокращается), но абсолютный прогиб требует модуля и нагрузки — этап 8.
- [ ] Оценить нижний периметральный пояс натяжения. Мерка задана решением 0015: пояс по периметру не ставит опору в середину дуги, значит потолка размера он не двигает вообще — он отвечает на другой отказ (распор пяток), и оценивать его надо по нему.
- [ ] Оценить один дополнительный кольцевой стабилизирующий пояс. Это первый кандидат, который пролёт действительно режет. Посчитано заранее: **один пояс и два пояса не сдвигают наибольший пролёт вообще** — у семейства G пять пролётов по 36°, а горизонтальное кольцо режет дугу ровно в двух точках, так что до трёх поясов один пролёт всегда остаётся целым.
- [ ] Проверить стратегию анкеровки и пути передачи нагрузки от обшивки.
- [ ] Строить только после того, как структурные допущения проверены и испытаны надлежащим образом.

**Критерий завершения:** определить, жизнеспособен ли D8 на базовой топологии плюс минимальном повторяющемся усилении.

## Этап 7 — Исследование XL-топологии: D10–D12

**Цель:** выяснить, насколько далеко масштабируется идея быстрой сборки, не притворяясь, что базовая конструкция масштабируется напрямую.

Кандидатные стратегии усиления для сравнения:

- периметральное кольцо/пояс натяжения;
- один или несколько кольцевых стабилизирующих поясов;
- дополнительные повторяющиеся усиливающие дуги;
- более плотная вторичная решётка Star Dome;
- частичная двойная решётка;
- стеклопластиковая труба вместо сплошного стержня;
- выделенный каркас входа/коридора;
- распределённая обвязка обшивки, передающая ветровые нагрузки на анкеры.

Для каждого кандидата сравнить:

- количество деталей;
- количество уникальных типов деталей;
- количество действий при полевой сборке;
- время сборки;
- транспортный объём/длину;
- наибольший неподкреплённый пролёт;
- вероятные режимы отказа;
- требования к анкеровке;
- взаимодействие со входами и коридорами.

**Критерий завершения:** выбрать одну XL-концепцию, достойную детальной инженерной проработки, либо установить практический потолок размера ниже 10–12 м.

### Мерка выбрана, и она одна

Девять критериев выше — это то, во что кандидат обходится. Сначала он должен пройти один: **что он делает с наибольшим неподкреплённым пролётом.** Решение 0015, `stardome/span.py`, [`span.md`](span.md).

Причина — пара показателей степени. Чтобы держать прогиб эталонного купола, пруток должен быть **не тоньше** `d₀(a/a₀)²`; чтобы его вообще можно было согнуть по радиусу купола, он должен быть **не толще** `2Re`. Первое растёт как квадрат пролёта, второе — только как радиус. Они пересекаются ровно один раз, и это пересечение и есть потолок семейства:

| допускаемая деформация | 0.2% | 0.4% | 0.6% | 0.8% |
|---|---|---|---|---|
| наибольший купол, паритет по собственному весу | **7.2 м** | 14.4 м | 21.6 м | 28.8 м |

Пролёт входит в квадрате, поэтому **вдвое короче пролёт — вчетверо выше потолок.** Больше ничто в списке кандидатов его не двигает.

Что уже известно про сам список:

- **пролёт одинаков на всех вариантах** — 1.0472 R, то есть 60° дуги. Это свойство решётки, а не диаметра, поэтому «D12 слишком большой» — утверждение не про D12;
- **периметральное кольцо, обвязка обшивки и труба вместо прутка опоры в середину дуги не ставят.** Они отвечают на другие отказы — распор пяток, отрыв ткани, масса — и потолка не двигают вовсе. Их место в сравнении — после того, как кандидат прошёл мерку, а не вместо неё;
- **одного и двух кольцевых поясов не хватает.** У семейства G пять пролётов по 36°, горизонтальное кольцо пересекает дугу ровно дважды, поэтому до трёх поясов хотя бы один пролёт остаётся целым и наибольший не сдвигается ни на градус. Три пояса опускают его до 22.24° — и упираются в семейство L, которое высокие пояса не достают;
- **на XL рез двери перестаёт быть обязательным.** Нерезаный высокий пролёт впускает `walk` с D 8063, `carry` с D 8656 и 2.2-метрового персонажа с D 9848, так что на D10 и D12 рез покупает ширину и высоту, а не проход — ценой двух лишних типов деталей (`BASE2` и `TERM`, причём про `TERM` расчёт не говорит ничего). Решение 0007 ставило дверь порталом в низкий пролёт и было право на D6, где рез — разница между «согнувшись» и «войти»; на XL эта посылка не держится. См. [`doorway.md`](doorway.md);
- **потолок задаёт не топология.** Он задан одним числом, которого нет ни у кого: допускаемой деформацией прутка. При 0.2% потолок ниже D8, при 0.4% — за D12. Это ровно тот пункт этапа 3, который ни от чего не зависит и до сих пор не сделан.

## Этап 8 — Структурная проверка и полевые правила

**Цель:** превратить перспективные прототипы в документированную систему временных конструкций.

- [x] Определить свойства материалов **по стандартам**, а не по испытаниям. `configs/materials.toml`, `stardome/material.py`, решение 0022. Три кандидата, эталон — композитная арматура АКС по минимумам ГОСТ 31938, у каждого числа свой источник. Испытания — по-прежнему этап 3, и пункт останется полуоткрытым, пока никто не купил бухту: минимум стандарта говорит, что вариант, который проходит, пройдёт на любом соответствующем прутке, но не говорит, что происходит с конкретным.
- [x] Установить расчётные случаи нагружения. `configs/loads.toml`, `stardome/loads.py`, решение 0021. **Только ветер** плюс собственный вес каркаса и обшивки: купол временный и зимой не стоит, и именно это превращает ответ в скорость ветра, а не в карту России. Снега нет намеренно, и это записано там же, где он появится, если правило эксплуатации изменится.
- [ ] Проверить стержни/трубы, коннекторы, пояса, опорные точки и анкеры. **Стержни проверены, остальное нет.** `stardome/strength.py`, `make strength`, см. [`strength.md`](strength.md). Коннекторы требуют усилий в узлах, а их даёт решённая рама, а не замкнутая форма.
- [ ] Определить погодные/ветровые эксплуатационные пределы. **Есть вилка, числа пока нет** — решение 0023. Балочное и мембранное прочтения расходятся вдвое-втрое по скорости, и сузить их может только рама.
- [ ] Определить критерии осмотра и вывода из эксплуатации для стеклопластика и печатных деталей.
- [ ] Написать инструкции по сборке, анкеровке, эвакуации и разборке. **Одно правило уже выведено и стоит бесплатно: закрыть дверь.** Открытый навстречу ветру проём впускает внутреннее давление, которое выталкивает оболочку всюду, где снаружи и так разрежение, и стоит около 1.3× по предельной скорости.

**Критерий завершения:** решения «строить / не строить» опираются на явные инженерные пределы, а не на зрительную уверенность.

### Что уже сказал расчёт

Три результата, и два из них разворачивают то, что проект о себе думал.

**Пруток сильнее всего нагружен на самом маленьком куполе, а не на самом большом.** Дуга согнута по радиусу купола и остаётся согнутой всё время, пока он стоит, то есть несёт `E·d/2R` постоянно — а стеклопластик под постоянной нагрузкой разрушается ползучестью при доле кратковременной прочности. Диаметр прутка квантован (8/10/12), радиус делится пополам, поэтому `d/2R` хуже всего там, где купол меньше:

| | D3 | D4 | D6 | D8 | D10 | D12 |
|---|---|---|---|---|---|---|
| деформация от гибки | **0.267%** | 0.200% | 0.167% | 0.125% | 0.120% | 0.100% |
| доля от 0.224%, разрешённых постоянно | **1.19** | 0.89 | 0.74 | 0.56 | 0.54 | 0.45 |

**D3 в нынешней конфигурации не проходит, стоя в полный штиль.** Ему нужен пруток 6.7 мм или купол побольше. Решение 0009 уже признало D3 доминируемым по площади пола; теперь есть вторая, независимая и более жёсткая причина.

**Купол не опрокидывается — он взлетает.** Давление нормально к оболочке, все нормали сферы радиальны, значит каждая сила проходит через центр сферы, а у голого купола центр лежит в плоскости земли: равнодействующая — чистая сила без момента. `interior.md` сравнивал варианты по индексу опрокидывания и сам оговаривал, что это сравнение формы и ничего не доказывает про безопасность; вот ответ, который он не дал. При 20 м/с голый M весит 36 кг, а ветер тянет вверх 353 кгс — **в десять раз больше собственного веса**, и держат это только десять забитых уголков.

**Отвечает устойчивость, а не прочность.** Каждый вариант, у которого вообще есть число, останавливает не разрыв прутка, а потеря устойчивости: 10-мм пруток на наибольшем свободном пролёте D6 держит 24.5 Н, а собственный вес дуги на том же пролёте — 4.8 Н. `skirt.md` мимоходом заметил то же самое про раскос; это верно и про сам купол. Отсюда же цена тридцати зажимов **в метрах в секунду**: около 1.4×, и она ограничена сверху тем, что слабое семейство меняется — при зажатых пересечениях худшим становится G, которому зажимы не дают ничего.

## Ближайший приоритет

Расчётом решено почти всё, что касается формы: геометрия, плетение, дверной проём, интерьер, расписание коннекторов, порядок сборки, бюджет допусков и **все шесть деталей, собирающиеся одной командой**. Дальше почти всё упирается в одно — **в пластике не проверено ничего**.

Одна оговорка к «решено». Купол был посчитан как форма и ни разу — как количество. **Ведомость теперь есть** (`make bom`, [`bom.md`](bom.md)): детали, печати, пластик, пруток, ткань, стропа, юбка и анкеры в одном месте. Пластик не хранится в исходниках, а измеряется по экспортированным сеткам, поэтому колонка есть после `make clamps` и честно отсутствует до него.

Первое, что ведомость показала: **опорные хабы были 59% пластика купола**. На M это было 4040 см³ из 6882, и одна `BASE3-10` весила как четыре с половиной веерных узла. Причину решение 0013 уже записало — габарит хаба задавал паз под колышек, а не пруток. Именно цена и заставила посмотреть на паз ещё раз.

С 13 сентября паза нет: уголок встречается с хабом на **площадке снаружи нижней плиты, а с трёх сторон его закрывает отдельная печатная обкладка на двух болтах**, поэтому 31-мм полоса под паз больше не прибавляется ко всей плите. После доработки 27 сентября проушины обкладки связаны перемычкой ниже края уголка, а стопка плит стянута четырьмя болтами. Нижняя пара отверстий стопки находится внутри широкой общей части каждой плиты, без узких перемычек к круглым проушинам. `BASE3-10` — 325 см³ вместо исходных 430; хабы — **52% пластика вместо исходных 59%**. См. решения [0025](decisions/0025-the-angle-is-met-on-a-pad.md), [0026](decisions/0026-the-loop-is-bought-not-printed.md), [0027](decisions/0027-the-wrap-closes-the-fourth-side.md), [0028](decisions/0028-join-the-wrap-ears-and-add-upper-stack-bolts.md) и [0029](decisions/0029-put-the-lower-stack-bolts-inside-the-base-plate.md). Сверлить в уголке не надо ничего, а единственная деталь, нарисованная вокруг покупного сечения, — сама обкладка, 59 см³: выбор `STAKE-BASE` перепечатывает её, а не хаб. 107 деталей — это 207 печатей, потому что деталь и печать не одно и то же. С 8 октября уголка нет совсем: опора — забивная арматура, и обкладку заменил ложемент с V-пазом на тех же двух болтах, 27 см³ вместо 56 у `BASE3-8`. Нижняя плита не изменилась ни на кубический миллиметр, так что уже напечатанные остаются в деле ([решение 0031](decisions/0031-the-stake-is-rebar-and-a-vee-takes-any-bar.md)).

Чего в количествах по-прежнему нет: транспортного габарита, массы и **карты реза и разметки для поля**. Число крепежа уже есть в расписании коннекторов и ведомости. Карта реза важнее прочего: без неё пункт 7 ниже нечем начинать — резать нечего.

С 12 сентября расчётом решено ещё и то, что формой не является: **наибольший неподкреплённый пролёт и потолок размера, который он задаёт** (`make spans`, [`span.md`](span.md), решение 0015). Оно же дало цену тридцати несвязанным пересечениям — 2.78× по диаметру прутка — и первую проверку предварительных диаметров из `variants.toml`, которую те не прошли.

С 13 сентября в проекте впервые есть **модуль упругости, нагрузка и вердикт** (`make strength`, [`strength.md`](strength.md), решения 0021–0023). Что это меняет по порядку:

- **D3 отпадает по расчёту**, а не по предпочтению, и пруток оказался тем тоньше нагружен, чем купол больше — обратно тому, что здесь предполагалось;
- **отказ — это подъём, а не опрокидывание**, и держат его только десять уголков, которые до сих пор выбраны наугад. Значит `STAKE-BASE` перестал быть последней строчкой расписания без ответа и стал позицией, от которой зависит предельная скорость ветра;
- **закрытая дверь стоит 1.4× по скорости и не стоит ни одной детали** — первое полевое правило этапа 8, выведенное раньше самого этапа;
- **числа как такового нет**: балочное и мембранное прочтения расходятся на порядки по напряжению, и оба заведомо неверны в известную сторону. Сузить вилку может только решённая рама, и это следующая работа.

Ещё один побочный итог: у материала появилась плотность, поэтому **у ведомости теперь может быть колонка массы** — то, чего `bom.md` о себе прямо говорит, что не умеет. Голый M весит 36 кг.

Конкретный путь:

1. напечатать по одному образцу каждой детали. Порядок по цене ошибки: `SPLICE` первым, потому что их 45 на купол и без них дугу не довезти; затем веер, зажим и опорный хаб;
2. купить пруток и измерить реальный допуск и поведение поверхности — единственный оставшийся невыполненный пункт этапа 3, который ни от чего больше не зависит;
3. на образцах выбрать между веерной деталью и стопкой двухстержневых зажимов, и заодно решить, нужны ли 30 несвязанным пересечениям зажимы вообще;
4. ~~закрыть найденное проверкой печатаемости у нижней плиты опорного хаба~~ — **сделано 13 сентября**. Диагноз был верен на обе половины: 2643 мм² плоского потолка — это крыша прорези под уголок, а гнёзда под гайки в этой детали вообще не прорезались. Прорези нет, гнёзда есть и с конусами: худший свес нижней плиты 50.1°, площади круче 45° — ноль, и ни одна плита хаба больше не требует поддержек. Заодно нашлась ошибка в самой проверке: выборка на краю грани читалась как материал, из-за чего гнездо под гайку, открытое **вверх**, показывалось как 91 мм² плоского потолка;
5. проверить на стенде два места, где геометрия молчит: держит ли гильза `SPLICE` изгиб, и выдерживает ли стенка `TERM` осевую нагрузку от торца дуги. Это единственные два соединения, про которые расчёт здесь не говорит ничего;
6. выбрать забивную арматуру `STAKE-BASE` по диаметру и глубине — последняя позиция в расписании, у которой нет ответа. Ложемент от диаметра больше не зависит, а жёсткость на изгиб зависит: у прутка 12 она в 11 раз меньше, чем у уголка L30×3;
7. и только потом собирать каркас D4 или D6 целиком (этап 4) — в порядке из [`assembly.md`](assembly.md), с секундомером, потому что число протаскиваний посчитано, а время одного из них нет.

Пункты 1–3 нужно делать по порядку; 5 и 6 независимы и могут идти параллельно.
