DurandalCode/star-dome/(list of files, cad)

Other CAD files:
dome/variants/star_dome_d4.scad
dome/variants/star_dome_d6.scad
dome/variants/star_dome_d8.scad
