DurandalCode/star-dome/(commit log)

2026-09-09 Add FreeCAD crossing clamp V1
    Work produced by the parallel "Star Dome crossing connector prototype"
    session and left uncommitted in the working tree. Committed as-is, without
    review or modification, so that the OpenSCAD dome geometry branch could be
    merged without overwriting it.
    Two-piece bolted clamp with flared mouths and 180 deg saddles, parametric
    across 8/10/12 mm rod diameters. Roadmap Milestone 3 partially ticked.
    Claude-Session: https://claude.ai/code/session_01JgvyzGQXqEib3L4ZQy7TW9
    [star_dome_crossing_clamp_v1.FCStd]
2026-09-09 Add parametric Takekawa Star Dome geometry in OpenSCAD
    Reproduces the SimplyDifferently / Takekawa Star Dome as 15 continuous
    great-semicircle bows on a decagonal base, with D4/D6/D8/D12 presets.
    The topology is reconstructed from the reference's bow-length formula and
    rod-marking diagram rather than guessed:
    - lbow = c/2 = pi*R makes every bow exactly half a great circle, so each bow
    spans two diametrically opposite base points. 15 bows over 5 diametral axes
    gives the reference's 3 rod ends per base point.
    - The marking diagram (10 rods in thirds, 5 in fifths, 2 base-ring rods in
    fifths) pins the three families: family G at tilt atan(2) is the
    icosidodecahedron's equatorial decago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
    [star_dome.scad, star_dome_d12.scad, star_dome_d4.scad, star_dome_d6.scad, star_dome_d8.scad, star_dome_geometry.scad, variants.scad]
2026-09-09 Add engineering geometry report, crossing taxonomy and debug render mode
    Turns the D6 geometry into a measured engineering report. Nothing about the
    dome's shape changed; this is analysis on top of the existing model.
    Per rod-to-rod crossing: stable node ID, both rod IDs and families, XYZ,
    arc position along each rod in degrees and mm, both unit tangents, the acute
    angle between them, each rod's inclination above horizontal, which rod passes
    above, the radial gap, lashed flag, and symmetry class.
    Findings:
    - 40 distinct crossing POINTS (10 with four rods, 30 with two) and 90
    rod-to-rod PAIRS. Both counts are reported; a connector clamps a pair.
    - 12 symmetry-distinct crossing geometries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
    [star_dome.scad, star_dome_geometry.scad]
2026-09-09 Freeze the OpenSCAD model as a reference implementation, check it in CI
    Python is now the source of truth, which puts the independent cross-check at
    risk: if dome/star_dome.scad stops computing its own geometry, we lose the
    second implementation that already caught a real field-labelling bug.
    So keep it, and make the split explicit rather than a matter of judgement:
    - dome/star_dome.scad is frozen as a reference implementation of the baseline
    topology. It keeps computing its own geometry -- that independence is the
    whole point -- but it does not grow.
    - Everything new (sections, ferrules, cut lists, belts, D12 reinforcement,
    load inputs) goes only into stardome/. None of it is sphere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
    [variants.scad]
2026-09-09 Generate crossing clamps from the dome model, and report what they miss
    Turns "how many connector types does this dome need" into a derivation.
    stardome/connectors.py groups every crossing into the part that would serve it;
    connectors/generate_clamps.py reads that schedule and drives the existing V1
    generator once per part, at that part's real crossing angle rather than the
    hand-picked 72 deg default.
    The answer for the baseline topology is awkward and worth stating plainly:
    - All 30 unlashed crossings are two-rod contacts at one angle, acos(1/3) =
    70.5288 deg. A single clamp geometry covers every one of them.
    - The 10 lashed nodes join four rods at a single point with six pairwise angle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
2026-09-09 Add the Blender scene builder, and split the two producers' output directories
    blender/build_scene.py builds the dome at 1:1 from model.json. Rods become
    poly curves bevelled at the real rod radius and coloured by family; every
    object carries its model ID (Rod_G1, Node_N07, Base_b0) so a regenerated
    variant can be matched against an existing scene. Tied nodes, unlashed
    crossings, base points and site objects get their own collections, with the
    unlashed markers built but hidden.
    The scene is metres at 1:1 against a millimetre model, so the 1.75 m scale
    figure and a 1.8 m doorway measure correctly against the rods -- the only
    reason to do this in Blender rather than judge it by eye.
    It requi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
2026-09-09 Derive the four-rod node: it is a flat fan, and one part serves all ten
    The lashed nodes looked like the hard case -- four rods at a point with six
    pairwise angles, which a two-rod clamp cannot serve. They are not.
    All four tangents at a lashed node are coplanar. A great circle's tangent lies
    in the sphere's tangent plane, and every bow is a great circle, so the four
    rods leave the node in one plane perpendicular to the radius. The largest
    out-of-plane component across every node of every variant is around 3e-16.
    So the node is a flat four-armed fan with the rods stacked along the radius,
    not a three-dimensional tangle. Read round, the gaps are always 37.3774,
    41.8103, 37.3774 and 63.4349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
2026-09-09 Check the weave globally: the naive route fails, a consistent one exists
    Fixing the stack at the ten lashed nodes says nothing about the thirty
    unlashed crossings a rod passes between them, and those rods must not share
    space either. So check it before designing the part.
    Routing each rod straight between the offsets its lashed nodes dictate leaves
    15 of the 30 unlashed crossings interpenetrating -- the worst leaves 1.12 mm
    between the axes of two 10 mm rods. Every stacking order fails this way; fan
    order is the worst of them, at 15 against 5 for the best. That is not an
    argument against fan order: linear interpolation was an arbitrary guess at the
    route between nodes, not a constraint of t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
2026-09-09 Confirm the four-rod node against the reference, and record what it changes
    The four-rod node was a reconstruction from the rod marking diagram, and the
    roadmap held it as something to check before spending effort on tooling.
    Checked, and it holds -- from the reference's own construction diagram rather
    than from a photograph:
    panel 1 the pentagram of 5 blue bows, with 5 junctions ringed.
    Two blue bows cross at each ring.
    panel 2 adds the 5 green bows. The same 5 rings now carry two blue plus
    two green.
    Four rods, in exactly the two-of-one-family, two-of-another pattern the model
    predicts. The reference's text states no number -- it says the count "varies by
    loca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
2026-09-09 Add the four-rod fan node connector, generated from the model
    The last unbuilt part. connectors/fan_node_v1.py builds the connector for the
    ten lashed nodes; generate_clamps.py drives it from the schedule, so the fan
    angles come from stardome rather than being typed into the generator. The
    whole connector set for a dome is now generated from the model: 40 parts, 0
    awaiting a generator.
    ARCHITECTURE, forced by one constraint
    Adjacent rods in the fan-order stack touch: their axes are one diameter apart
    and they meet at the crossing point, and the vertical gap between their
    surfaces stays zero all along. There is nowhere to put material between them,
    so a plate-per-layer sandwich cannot exist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
2026-09-09 Make the fan node printable, and halve it
    Both halves now print without supports: worst overhang 50.06 deg on the base
    and 49.99 deg on the cap printed upside down, against a 45 deg limit, with zero
    flat unsupported ceiling on either. The worst face in each is the deliberate
    taper off a fastener recess. Neither half has a horizontal round hole -- every
    rod channel is an open groove facing the sky in its print orientation, and the
    bolt holes are vertical -- which is a property of the architecture rather than
    of tuning.
    Also stops using a solid disc for both halves. A disc is mostly dead material:
    the part only has to hold the rod at the centre and reach the two bolts. A hub,
    two spars and tw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
2026-09-09 Fillet the fan node, and fix two more bugs in its own checks
    Vertical silhouette corners on both halves at edgeRadius, and the rim of each
    part's upward face in its print orientation at 60% of that: 26 + 7 edges on the
    base, 16 + 25 on the cap. Bed-contact faces are left sharp, because a fillet
    there costs first-layer adhesion. Filleting the upward face also rounds where
    each rod channel opens onto it, which is the edge that would otherwise bear
    into the rod -- the point of doing it rather than a side effect. Edges that
    cannot take the radius are skipped: a missing fillet is cosmetic, a failed
    solid is not.
    The fillet helper is copied from crossing_clamp_v1 rather than shared. Both
    files ar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
2026-09-09 Replace the fan node with a stack of plates that actually holds every rod
    V1 did not locate the middle two rods at all. It clamped the four as a bundle
    -- saddle under rod 1, cap over rod 4 -- and rods 2 and 3 were held by nothing
    but friction inside the squeeze. The dome's shape depends on the rods crossing
    at the right angles at the right points, and friction is not a guide. The user
    put it plainly: nothing in there guides the rods.
    V1 defended that with a constraint it called governing: adjacent rods touch, so
    there is no room for material between them. That is true only because V1 set
    the stack pitch to exactly one rod diameter, inherited from the two-rod clamp
    where the rods deliberate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
2026-09-09 Export the reference rods and a whole-node assembly
    The rods were already in the FCStd, in the Reference group, but nothing put
    them in the exported set -- so the STEP files and any slicer preview showed
    five plates and no sign of what they hold, which makes the node hard to read.
    Adds, per node:
    <id>_ref-Rod1..4 the four rods, as STEP and STL
    <id>_ref-Assembly five plates and four rods in place, one file
    Named ref- so nobody prints one by accident. The assembly is a compound rather
    than a fusion: it is for looking at, and fusing plates to rods would produce a
    solid that means nothing.
    Claude-Session: https://claude.ai/co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
2026-09-09 Tighten the stack: flare the tilt clearance instead of widening the channel
    Stack pitch 17.86 -> 13.40 mm, which is the floor for a 3 mm web: two channel
    radii plus the web, nothing else in the way. Stack height 53.6 -> 40.2, assembly
    77.3 -> 63.9, bolts M5x80 -> M5x70, 139.8 -> 115.7 cm3. The web still measures
    2.95 mm against 3.0 requested, the difference being the probe step.
    WHERE THE HEIGHT WENT
    Tilt clearance was widening each channel uniformly along its whole length. That
    is wrong twice over: the tilt is a rotation of the rod about the transverse axis
    through the node centre, so the rod is on the nominal axis at the centre and
    deviates only towards the ends -- and the centre is exac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
2026-09-09 Let the rods touch: the plate becomes a cross with a hole at the middle
    I had this wrong for two revisions, and the user caught it. The reasoning was:
    rods touching means no room for material between them, so the pitch has to open
    up. That is only true AT the crossing point.
    Move away from the centre and the two rods diverge in plan. Their axes stay one
    diameter apart vertically, but the gap between their SURFACES opens up, because
    a vertical line off the axis cuts a shorter chord of each cylinder. So material
    can live between two touching rods everywhere except a small lens around the
    crossing.
    With the pitch set to exactly rodDiameter, the two channels of a middle plate
    overlap near the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
2026-09-09 Keep the rods touching, colour the view, stop tracking generated FCStd
    Three things.
    RODS TOUCH, AND THE PITCH IS ONE DIAL
    The two pitch modes are replaced by a single number, rodGap: the pitch is
    rodDiameter + rodGap, so it says directly how far apart adjacent rods sit at
    the crossing. Default 0 -- they bear on each other, as intended, and the plate
    has a hole at the node centre where the two channels overlap.
    Every millimetre of gap thickens the rib by a millimetre at every radius,
    closes the centre hole once past 0.4 mm, and costs 3 mm of stack height:
    gap 0 pitch 10.0 stack 30.0 rib: hole at centre, 1.95 mm at r=10
    gap 1.5 pitch 11.5 stack 34.5 rib: 1.05 at centre, 3.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
    [star_dome_crossing_clamp_v1.FCStd]
2026-09-09 Add D3 with a skirt and D10, and a scene with the whole family at 1:1
    THE FAMILY
    Six variants now: D3, D4, D6, D8, D10, D12. D3 needs a skirt, because a Star
    Dome hemisphere is only 0.982*R tall and 1.47 m is a crawl-in shelter, not a
    room. Standing the hemisphere on a vertical skirt is the reference's own answer
    and it keeps the geometry intact -- distorting the dome into a three-quarter
    sphere would stop the bows being great semicircles, break lbow = pi*R, and turn
    15 identical rods into 15 different ones.
    D3 3 m wide 1.47 m dome + 1.0 m skirt = 2.47 m
    D4 4 m 1.96 m
    D6 6 m 2.95 m
    D8 8 m 3.93 m
    D10 10 m 4.91 m
    D12 12 m 5.89 m
    THE S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
    [variants.scad]
2026-09-09 Derive the parity guard's file count from the config
    The guard that stops the parity job passing on skipped tests asserted exactly
    four export files. Six variants landed and it failed on its own literal --
    which is the mistake this project keeps calling out everywhere else.
    The count now comes from configs/variants.toml, so adding a variant cannot
    break the guard, and the step prints both numbers so a mismatch says which
    way it went.
    Claude-Session: https://claude.ai/code/session_01RnsHZXxRLjqXZRzPsQjYxN
2026-09-09 Compute where a door fits, and find that D6 cannot take one
    Milestone 2's entrance-clearance item, done as measurement rather than by eye.
    THE METHOD
    Unroll the dome: map every rod point to (azimuth, z) and the structure becomes
    a flat elevation 360 degrees wide, in which a ground-standing doorway is an
    axis-aligned rectangle on z = 0. For each azimuth the free height is the lowest
    a rod reaches there less its radius -- a door envelope. The widest door of a
    given height is then the longest run at or above it, and the largest door by
    area is largest-rectangle-under-a-histogram, solved exactly on the circular
    array rather than sampled.
    THE RESULT, WHICH CHANGES THE SIZE QUESTION
    The talles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
2026-09-09 Measure the room: standing floor, and what a skirt is really worth
    Two answers to two questions, both by measurement.
    A DOOR SHAPED LIKE A PERSON, NOT A RECTANGLE
    entrance.TEMPLATES tests a silhouette -- wide at the shoulders, narrower at the
    head, which is exactly the trapezoid under two crossing bows -- instead of an
    inscribed rectangle. It finds openings a rectangle misses.
    It does not move the walk-in threshold, and that is worth saying plainly. Below
    D10 the binding constraint is not width but the ceiling: a door stands on the
    ground, so its height is capped by the lowest rod over that azimuth, and D6's
    free height never exceeds 1528 mm anywhere. No door shape beats that. What the
    sh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
2026-09-09 Compare skirted variants against each other, not against bare ones
    docs/interior.md concluded that D3 on a skirt beats a bare D4, and left
    D4 filed as "the worst of the family". Both are true and neither is the
    comparison that decides a size: every variant that needs a walk-in door
    needs a skirt, so the honest test is skirt against skirt.
    Held to the same 1800x700 door, D4 + 1320 mm beats D3 + 1600 mm on
    standing room (11.84 vs 6.94 m2), tip index (0.740 vs 0.939) and rod
    efficiency (0.099 vs 0.072 m2/m). D3 + skirt is dominated; its only
    remaining arguments are the 3 m footprint and 24 m less rod.
    Across the family with the door requirement held constant, tip index
    falls and rod efficienc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
2026-09-09 Name the door: which bay, framed by what, and its outline in space
    `entrance` answers "how big an opening will fit somewhere". The next
    question is which opening, and that turns out to have a good answer the
    structure supplies for free.
    Unrolled, the dome leaves ten ground-standing gaps in two sizes, five
    tall and five low, alternating. Each tall one is a lancet: two G bows
    springing from adjacent base points and meeting overhead at a lashed
    four-rod node. So a doorway is framed top and bottom by joints that
    already exist. Nothing is cut -- which matters, because every bow runs
    unbroken from base to base and shortening one to widen a hole does not
    trim a member, it deletes one.
    The head si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
    [variants.scad]
2026-09-09 Draw the doorway, and stand the four sizes up facing it
    The opening now travels in model.json as a closed 3D outline, so the
    Blender scripts draw it instead of rediscovering it -- the same consumer
    contract as everything else in blender/.
    build_scene highlights the two jamb rods, outlines the opening, fills it
    faintly so it reads as a hole rather than another line among fifteen,
    puts the figure *in* the doorway, and aims the camera down the door's own
    azimuth. build_site gains --named-only for the four sizes that are an
    actual build, spins each dome so its door faces front, and labels by
    short name. Spinning changes nothing: the structure is five-fold
    symmetric.
    make sizes S, M, L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
2026-09-09 Leave M and L bare, and put a 2.2 m character in every doorway
    Dropping the skirt from M and L is cheap to write and expensive in the
    middle of the range, so the config now records what each dome actually
    admits rather than what would be nice. A bare D6 is 497 mm wide at
    1200 mm and 209 mm at 1400: you go in on all fours. A bare D8 gives
    908 mm at 1400, so you duck, and 384 mm at 1800, so you do not walk.
    Only at 10 m does the lancet alone clear a standing person. S keeps its
    skirt because a 4 m dome without one admits nothing at all.
    The model gains `admits`: every silhouette that gets through, not just
    whether one chosen one squeaks past. Naming only the choice hid both
    failures and headr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
    [variants.scad]
2026-09-09 Measure what cutting the doorway open actually buys
    Every bow is divided by its crossings into pieces, and each piece ends
    at a lashed node, so a cut lands on a joint rather than mid-span. That
    makes enlarging the door by removing pieces a real option -- but the
    pieces are not equal, and the difference is the whole question:
    an END piece the bow gets shorter and still runs unbroken from a
    base point to a node. Nothing is severed.
    a MIDDLE piece the bow becomes two disconnected bows. A different
    structure, not a modified one.
    The doorway's own jambs turn out to be end pieces. Each G bow is exactly
    five equal fifths -- its crossings fall on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
2026-09-09 Cut the door open on M and L
    `door_cut` in the variant config takes the doorway's two jamb pieces out
    for real: the model reports the opening that leaves, the rods carry the
    removed spans so a consumer can draw them, and Blender shows both what
    is left and, in red, what was taken away. A door you cannot see the
    price of is a door that looks free.
    M crawl -> stoop 1528 -> 1563 clear, 497 -> 1833 wide at 1200
    L stoop -> carry 2038 -> 2085 clear, 384 -> 1676 wide at 1800
    Open area goes from 0.042 to 0.072 of D squared, and the cut costs 2.67%
    of the rod at either size with no bow severed.
    Once pieces are gone the opening stops being a lancet -- on a cut M bay
    th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
    [variants.scad]
2026-09-09 Cut the door to the head node, and fix how a door was being measured
    `door_cut` becomes a level -- "none", "jambs", "head" -- and M and L go
    to "head": the two jamb pieces plus the two that still cross above them.
    M crawl -> walk 1528 -> 2252 clear, 668 wide at 1800
    L stoop -> carry 2038 -> 3004 clear, 2060 wide at 1800, and the
    2.2 m character gets in
    Two things this level costs that the jamb cut did not. L1 and L5 are
    severed, and although each half still runs from a base point to a node,
    what is lost is continuity through the node between them. And at the
    head node nothing passes through at all: four bows converge and every
    one of them terminate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
    [variants.scad]
2026-09-09 Put M and L back to the jamb cut
    The head-level cut is not what these should ship with. It leaves the
    head node with nothing running through it, so the door head wants a
    lintel that does not exist yet, and it opens the bay asymmetrically --
    2156 mm at one edge down to 1301 at the other, which makes the
    walk-through a slot at one side rather than a door.
    The jamb cut is the one that costs nothing structurally, and it is the
    version that was actually looked at and approved. The head level stays
    available as `door_cut = "head"` and keeps its tests; it is just not
    what M and L are.
    Claude-Session: https://claude.ai/code/session_01RnsHZXxRLj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
    [variants.scad]
2026-09-09 Put the door in a low bay: a portal with a lintel
    The door was in the wrong bay. The five *tall* bays are pointed arches
    whose head is a node at 0.2629 of D; the five *low* ones are bounded by
    two U bows rising from adjacent base points and, across the top, one L
    bow lying nearly level between two crossings at the same height. That is
    a doorway with a lintel, and it stands higher: 0.3009 of D.
    What fills it is a second pair of L bows crossing low in the middle --
    b8 - N18 - N19 - b9 with N39 in the way, on M. Each of those two bows
    gives up its end piece **and the piece past that crossing**. Both spans
    run contiguously to a bow end, so neither is severed: each simply starts
    higher up.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
    [variants.scad]
2026-09-09 Give every size the portal door
    Unifying on the portal is not a compromise for the sake of one detail:
    it is better at both ends of the range.
    S keeps its 1350 mm skirt, because on a 4 m dome the skirt is what buys
    standing room and not just a door. With the portal instead of the lancet
    the same skirt gives a 2560 mm opening rather than 2368, admits a 2.2 m
    character, and uses 2 m less rod. Nothing else moves: same 11.93 m2 of
    standing floor, same 0.747 tip index. Strictly better at the same price.
    XL needed no cut at all -- its lancet already takes anyone. The portal
    still doubles the door: 2313 mm of clear width at shoulder height rather
    than 1091, for 2.8% of the rod. On a hall that peo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
    [variants.scad]
2026-09-09 Add a camp scene, and make a broken scene script say so
    `make camp` puts one S, one M and one L round a yard with the doorways
    actually cut out instead of ghosted -- the thing as built, where
    `make sizes` is the decisions in it. --hide-cuts leaves the removed
    pieces out, --camp sweeps the ends of the row back, and placement gains
    a second axis to allow it.
    Fixes the bug that made that necessary to notice. Blender exits 0 even
    when a --python script raises, so build_site.py has been failing on an
    indentation error while every target reported success and left the
    previous render in place, looking current. --python-exit-code 1 on all
    three Blender targets makes it fail loudly. The stale render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
2026-09-09 Brace the skirt: two rings and a crossed pair per bay
    The skirt was ten posts and one ring, which is a mechanism -- every bay
    is a parallelogram and the whole thing folds over under any sideways
    load. It now carries three things it did not, all as real members.
    The **top ring** is not only the skirt's. A dome pushes outward at its
    feet, and the ten base points of a bare Star Dome are ten free rod ends
    with nothing tying them to each other. Something has to take that thrust
    in hoop tension whether there is a skirt underneath or not; the top of
    the skirt is just where it lives here. The **bottom ring** closes the
    far end of every post. The **diagonals** triangulate each bay.
    Both rings are c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
2026-09-09 Give D12 the portal too
    The last variant that was still on the uncut lancet. Nothing about it
    argues for a different door -- the shape is the same at every diameter,
    so it gets the same one and the family is now uniform end to end.
    D10 3029 clear, 2313 wide at 1800, 2094 at 2200
    D12 3636 clear, 2932 wide at 1800, 2723 at 2200
    Both take everything, including the 2.2 m character, with metres rather
    than millimetres to spare. D12 remains explicitly unvalidated and 5.9 m
    tall to stand up.
    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
2026-09-09 Actually open the skirt bay under the door
    Taking the diagonals out of a bay does not make a doorway. Both rings
    still ran straight across it: one along the ground to trip on, one at
    the top of the skirt at head height. Neither is a hole, and the drawing
    looked much the same either way, which is how it got past a review.
    The door bay now loses both ring chords as well. That leaves the top
    ring an open arc, which carries no hoop tension at all, so the force
    takes a detour over the opening: post head, up the U bow rising from
    that base point, across a header between the two U bows, and down the
    other side.
    On S the header spans 959 mm at 1950 mm above ground -- 150 mm over an
    1800 mm silhoue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
2026-09-09 Put the header above what the door admits, not what it is sized for
    The header was placed on the nominal door silhouette -- 1800 mm plus a
    margin -- and S is nominally sized for someone carrying something. But
    S's portal passes a 2.2 m character, so the lintel landed at 1950 and
    took that back. A lintel that blocks what the doorway was letting
    through is not a lintel, it is an obstruction.
    It now clears the tallest silhouette the opening actually admits. On S
    that moves it from 1950 to 2350 mm above ground, span 959 -> 701 mm,
    still under the dome's own 2560 mm opening. verify walks the admitted
    list and fails on any of them the header would stop.
    build_scene gains --hide-cuts, which build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
2026-09-09 Count the joints that are not crossings
    The connector schedule answered "how many clamp types does the lattice
    need" and stopped there: two parts, forty crossings, nothing missing.
    That was true and it was most of the question left out. It said nothing
    about where the dome meets the ground, the skirt, or itself lengthwise,
    and those joints outnumber the crossings.
    S 40 crossings covered, 54 joints with no design at all
    M 40 covered, 57 with none
    XL 40 covered, 100 with none
    Five families it did not know about.
    **The base point is the busiest joint in the structure.** Three bow ends
    arriving at three different inclinations, and on a skirted dome the post
    head from below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
2026-09-09 Separate what must be made from what must be chosen
    A driven steel angle takes the ground anchorage at every point that
    touches the earth: it resists uplift and, through the soil, the
    horizontal thrust, the way a tent peg does. That is hardware -- a size
    and a length to specify, not a shape to design -- and it removes a
    column from the list of things this project has to draw.
    The schedule now says so. Parts carry a state: generated, hardware, or
    undesigned.
    M 40 generated, 10 hardware, 57 with nothing at all
    S 40 generated, 10 hardware, 44 with nothing at all
    What the stake does *not* do is gather three bow ends arriving at three
    different inclinations and hold them to each ot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
2026-09-09 Render the views an event actually asks about
    A three-quarter view answers "what shape is it", which nobody was
    asking. `make shots` renders eight views of every size, most of them
    from eye level -- 1.70 m, below the top of a head rather than at it.
    outside the whole thing, three-quarter, door towards you
    approach standing 4 m out, about to walk in
    doorway in the opening itself, looking in
    inside from the middle, looking back out of the door
    inside_back from the middle at the far wall, level, because the
    question is where the ceiling crosses eye height
    up straight at the crown, on an 11 mm lens or it shows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
2026-09-09 Fit the whole plan in the frame
    ortho_scale governs the wider axis of the frame, and the frame is 16:10,
    so a plan sized from the diameter fitted across and ran off the top and
    bottom. On D12 that cut a metre and a half off each end of a drawing
    whose whole job is to be measurable.
    Sized from the short axis now and multiplied back up. The elevation is
    wider than it is tall, so the diameter governs there directly and it was
    already right.
    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
2026-09-09 The base point is a flat fan too
    Before drawing the busiest joint in the structure, measure it. A great
    circle through a point on the sphere's equator has its tangent there in
    the surface, and the surface at the equator is the vertical plane
    tangent to the base ring -- so all three bows leave a base point in one
    plane, with no radial component at all. Residual 5e-16.
    That is the same reason the four bows at a lashed node are coplanar, and
    it means the base hub is the node's part with one arm fewer rather than
    some new kind of thing.
    node fan gaps 37.3774, 41.8103, 37.3774 four arms
    base fan gaps 41.8103, 37.3774 three arms, spread 79.1877
    It shares both of the bas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
2026-09-09 Draw the base hub: the node's fan with one arm fewer
    connectors/base_hub_v1.py builds it, and it is not a new kind of part.
    The three bows leaving a base point are coplanar for the same reason the
    four at a lashed node are, so this is fan_node_v2's plate stack with
    three arms instead of four:
    plate 0 bottom groove up for arm 1
    plate 1 middle arm 1 down, arm 2 up 41.8103 deg apart
    plate 2 middle arm 2 down, arm 3 up 37.3774 deg
    plate 3 cap groove down for arm 3
    Four prints per hub, ten hubs per dome, and the ten base points are two
    mirror sets of five, so one geometry turned over serves them all.
    Three things differ, and all three make it smal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
2026-09-09 Draw the base hub's reference rods long enough to read
    They were 88 mm, which is barely past the arm, and the three directions
    the part exists to hold did not show at all. 300 mm now, on a parameter.
    Drawing only, with one exception in the right direction: the same solids
    are what verify() intersects against the plates, so a longer rod makes
    the interference check strictly stricter. There is no part out there for
    it to hit, and it still reports 0.0 mm3 with the plate volumes unchanged.
    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
2026-09-09 Make the stake an actual angle, and pin the palette
    THE STAKE
    It was modelled as a flat blade in a rectangular slot, and it is an
    angle: 30 x 30 x 3, half a metre, mostly in the ground. The section
    matters. A blade in a slot can rotate in its own plane; an L cannot,
    because turning it drives one leg into the side of the slot. The hub
    gets its resistance to twisting on the stake out of the section, free.
    So the slot is an L too, built in a local frame and turned to the
    bisector of the empty sector the same way the rod channels are. The
    angle is drawn as a reference solid -- 85500 mm3, which is exactly
    (30x3 + 27x3) x 500 -- and verify() now checks that no plate eats into
    it and that its 30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
2026-09-09 Let the angle pass right through the base hub
    A blind slot means controlling the driven depth to the millimetre,
    standing in a field, ten times per dome. A through slot means driving
    the angle to whatever depth the ground gives and dropping the hub on to
    find its own height.
    Two things had to move to allow it, and one of them is not free.
    WHERE IT COMES OUT
    The axis is no longer the bisector of the empty sector. That sector is
    281 deg wide, but its opposite direction lands 2 deg from an arm, so an
    angle following it would come out through the U rod. The axis is now set
    by where it has to *exit*: the middle of the widest gap between two arms,
    which puts it 20.9 deg clear of both.
    WHERE IT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
2026-09-09 Centre the reference angle on the hub
    It was drawn from 33 mm behind the hub, so nearly all half a metre of it
    stood out one side and the slot read as a socket the angle bottoms out
    in. Centred now: 250 mm either way, and the through hole is visibly a
    through hole.
    A reference solid, not a placement. On site most of that length is in
    the ground.
    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
2026-09-09 Shorten the base hub's tail: an arm is a ray, not a line
    The bolts have to clear the rods, and the formula for how far out they
    must sit was copied from the four-rod node, where every rod passes
    through the hub and out the other side. At a base point they do not:
    the rods END there, and there is nothing on the far side at all.
    Treating them as lines made a bolt sitting nearly opposite an arm look
    blocked by a rod that is not there -- 3.3 degrees from the arm's own
    reflection, so sin of the separation came out at 0.057 and the offset
    needed to "clear" the phantom ran to 247 mm. The tail reached out that
    far to carry the bolt, and the bottom plate came out 311 x 168.
    An arm more than 90 degr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
2026-09-09 Draw the base hub in the frame it stands in
    The stake is DRIVEN, so it is vertical. Nothing about that is
    negotiable: you hammer it into the ground, and the ground is down.
    An earlier version put it on the bisector of the widest gap between
    arms, which gave it the most room and had it entering the earth 32 deg
    off plumb. Room is worth having; plumb is worth more.
    Rather than rotate the drawing to suit, the part is now built in the
    frame it lives in. An arm's azimuth IS its rise above horizontal, so
    +X is horizontal, -Y is straight down, and a Top view shows the hub
    exactly as it sits on the ground -- arms at 37.3774, 79.1877 and
    116.5651, stake at 270.
    stake bounding box 30 x 500 x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
2026-09-09 Give the base hub's bolts something to pass through, and a slide fit
    TWO BOLTS THROUGH AIR
    There was no material round them. The bolts sit 35 mm out on azimuths
    55 deg either side of the stake; the hub disc reaches 22 mm and the tail
    to the stake slot is 15 deg wide. So both holes were cut through open
    space and the stack had nothing holding it together -- and it looked
    exactly the same in a render, which is why it survived.
    Each plate now carries a boss at each bolt with a web back to the hub,
    so the boss is carried rather than perched. verify() checks it the only
    way that means anything: the material that must exist round each bolt,
    in each plate, as a volume.
    Bottom 10195 mm3 round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
2026-09-10 Give the connector generators one toolbox to share
    Four generators had each grown their own copy of the same CAD primitives:
    raise a rod, cut a hex socket, fillet a set of edges, keep a parameter
    spreadsheet. connectors/kit.py collects the ones that were genuinely
    identical, and crossing_clamp_v1 is the first to use it.
    Two of the copies were hiding under different names -- axis_dir was
    direction and rod_cylinder was rod_solid, byte for byte in the body.
    What stays in each part is the part: build, verify, derived_rows, populate
    and the channel and plate shapes. Those share names across the generators
    but only 2-40% of their text, because they are four different objects.
    fan_node_v1 is lef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
2026-09-10 Move the fan node onto the shared toolbox
    948 lines to 707. The printability check goes with it, which is the piece
    worth sharing most: it took five wrong versions to get right, and the next
    part to need it should inherit the right one rather than the first one.
    The file's own docstring predicted this refactor and deferred it, on the
    grounds that sharing needs a path loader in each script and the family had
    not settled. The loader is six lines, and Milestone 5 adds three to five
    more parts, so the note is now out of date and says so.
    Every solid and every verify() field, printability included, is unchanged.
    Claude-Session: https://clau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
2026-09-10 Move the base hub onto the shared toolbox
    919 lines to 822. This one could not be merged by name: three of its helpers
    looked like the fan node's and meant something else.
    azimuths_from_gaps the hub's fan is open, so n gaps give n+1 arms; the
    node's closes on itself and the last gap runs back to
    the first. The kit does the honest running sum and the
    node passes gaps[:-1], which says why at the call site.
    rod_solid a bow ENDS at a base point, so the solid is a ray from
    the hub, not a cylinder centred on it. Two names now,
    rod_solid and rod_from_hub, rather than one wit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
2026-09-10 Move the clamp driver onto the shared toolbox, and finish the extraction
    export_solid was the one shared helper locked inside the driver rather than
    inside a part, which meant a generator that wanted to write an STL had to be
    run through this file to get one. It moves to the kit; the driver keeps a
    two-line wrapper that binds the output directory.
    The driver also called write_parameters through each part's namespace on the
    old four-argument signature, which the previous two commits had already
    retired. Nothing caught it because nothing runs these files but `make clamps`.
    REPO now goes into each loaded module's namespace instead of being
    rederived from __file__, and the last absolute /Users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
2026-09-10 Actually check whether the base hub prints
    The file declared OVERHANG_LIMIT_DEG and NEGLIGIBLE_FACE_MM2 and used
    neither: the constants of a printability check with no check under them. The
    fan node next door had the real one. So the part under active development was
    the one nobody was measuring for overhangs.
    Now that printability() is in the kit, wiring it in is one dict comprehension,
    and verify() reports the same block the fan node does.
    It does not like the Bottom plate: 2643 mm2 of face at a worst overhang of
    0.0 deg, which is a flat downward ceiling, plus 2965 mm2 steeper than the 45
    deg limit. Two candidates, both plausible and neither fixed here -- the stake
    slot's roof is a recta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
2026-09-10 Give the two Blender builders one drawing kit
    build_scene.py and build_site.py draw different pictures out of the same
    model, and five helpers were byte-identical in both: rod_runs, segment,
    make_transparent, new_collection, move_to. A sixth, the material factory,
    differed only in that build_site would have raised on a Principled BSDF
    without a Roughness input where build_scene guarded it; the kit keeps the
    guard.
    836 + 589 lines becomes 722 + 479 + 135.
    The palette, the camera, the figures and the layout stay in each builder,
    because that is what makes them two pictures rather than one.
    make blender and make site both render: D6 with its doorway panel still
    translucent, and the six-varia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
2026-09-10 Перевести дорожную карту на русский и закрыть то, что уже сделано
    Перевод целиком, плюс четыре галочки, каждая проверена по репозиторию,
    а не по памяти:
    этап 3, выбор диаметра стержня configs/variants.toml: 8 для D3/D4,
    10 для D6/D8, 12 для D10/D12. Это выбор;
    измерение реального прутка -- отдельный
    пункт, он остаётся открытым.
    этап 3, согласовать з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
2026-09-10 Close milestone 2: the fabric cover and a covered corridor
    The two things the milestone was missing, both computed in the core and drawn
    from the model rather than rebuilt in Blender.
    THE COVER (stardome/cover.py, docs/cover.md)
    It does not lie on the nominal sphere. Rods weave off their great circles and
    the fabric rides on the outermost rod surface, so D6's cover is 3075 mm not
    3000: 2.5% more radius, 5.1% more fabric, 5.1% more sail area to hold down.
    That number used to depend on which drawing convention the model was built
    with -- flat mode reported 3005 mm. meta.max_diameter_woven is now derived
    from the layered offsets whatever mode was asked for, because the weave is a
    fact about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
2026-09-11 Solve the assembly order instead of guessing it
    Rule 1 says fast assembly is a first-class requirement, and nothing in the
    repository measured it. Everything so far describes the dome once it is
    standing.
    Laying a bow on top of what is up is free; passing it under something already
    up is the hard move. Count those and an assembly order has a cost. Two bows
    cross at most once -- two great circles meet at one antipodal pair and a bow
    covers exactly the half above the ground -- so the weave is a digraph on 15
    vertices with 90 arcs, an order is a linear extension, and the cost is the
    arcs pointing backwards. That is minimum feedback arc set, which is NP-hard in
    general and nothing at all at n=1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
2026-09-11 Write down what the order costs, and where the cost is bought
    Four results worth keeping: there is no threading-free order at all, because
    the weave is cyclic; the floor is 21 of 90 and identical at every size, so D3
    and D12 are the same build; 20 of the 21 are forced by the ten lashed nodes
    before any weave routing happens; and the family-by-family order a person can
    actually be told costs 34, splitting on the single rule that L goes up before
    U.
    The roadmap gets the milestone 4 paragraph it implies, and says plainly that
    none of this closes a checkbox there -- every one of them is physical.
2026-09-11 Say how accurately this has to be measured, and what to measure it with
    The assembly order says which bow goes up when. Nothing said how carefully to
    cut and mark it first, which is the other half of whether the thing goes up
    quickly.
    Three things get measured in the whole structure: ten pegs, fifteen lengths,
    forty marks. The other thirty crossings nobody marks at all. So the budget is
    over those, and it comes out with two exact size-independent derivatives, both
    below one -- the shape attenuates error rather than amplifying it -- and one
    result that matters more: uniform error is free, because marks are fractions
    of each rod's own length, so only the differences bind. Watch the node sprea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
2026-09-11 Measure the mismatch against the bending, not against the rod diameter
    The tolerance this asked for was two millimetres on the pegs, and that was
    wrong. It came from a criterion I picked because it was tidy -- the four marks
    at a node should overlap within a rod diameter -- and a mark is a build aid,
    not a stop. The connector seats where the four rods agree to cross, not on
    anybody's mark, and the rods run through it and slide in their channels.
    Nothing fails when the marks stop overlapping.
    The operative question is what the mismatch costs in bending, and it is still
    pure geometry: a spread s sprung across a span a is a parabola of curvature
    2s/a^2, against the 1/R the rod already holds. T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
2026-09-11 Write down why it is like that, and what the words mean
    Twelve decision records and a glossary. Neither adds a capability; both stop
    the project losing what it already knows.
    The valuable thing here was never the geometry, which can be recomputed. It is
    the reversals -- OpenSCAD as the producer, MCP as the way to drive the tools, a
    lancet door, D3 on a skirt, spacing the rods apart at the node, judging a node
    mismatch by a rod diameter. Every one of those was the obvious answer first,
    every one was measured and lost, and every one currently lives only in the body
    of a merged pull request that a clean clone cannot see and grep cannot reach.
    So the records say what was chosen, what was rejec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
2026-09-11 Stop the documents saying what stopped being true, and test that they cannot
    Four documents were still describing the dome the project had before the
    portal door. The maths was right, the suite was green, and every sentence a
    reader would actually act on was wrong.
    entrance.md recommended 760 mm of skirt for D6 and said the middle of the
    range could not be walked into. interior.md called D6 + 760 the reference
    prototype. roadmap.md repeated both. All three were true of a rectangular door
    fitted under a tall bay, and all three stopped being true when the door moved
    to a portal in a low bay.
    README was worse, because it was a table of facts rather than an argument:
    three of its four rows und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
2026-09-11 Put the connectors on the dome, and find out what does not fit
    Nothing had ever placed a printed part on the structure. Doing it turns up
    four things, three of them errors the parts list was carrying.
    The portal cut costs two feet a bow each -- b0 loses L1, b1 loses L4 -- and
    those two are exactly the feet the doorway stands between. The schedule went
    on asking for ten identical three-arm hubs. It now asks for eight, plus two
    BASE2 that hold the two arms actually there: same U and G bows, the same
    37.3774 deg apart at both, mirror images, so one more print. TERM resolves to
    the crossings the cut bows now end in -- N26 and N25 on M -- with the angle,
    the surviving rod and which way it runs,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
2026-09-11 Design the last two connectors, and the dome is a parts list
    TERM and SPLICE were the two entries in the schedule with nothing behind
    them. Both exist now, and with them M needs 97 generated parts and ten
    driven steel angles, and nothing else.
    TERM is the crossing clamp with one channel closed, built on top of it
    rather than beside it -- everything structural about a two-rod clamp is
    already argued in that file and restating it would only let the two drift.
    The terminating bow gets a 5 mm wall behind its end and keeps its flare at
    the mouth it comes in by. One thing follows that is worth saying out loud:
    this is the only joint in the dome where load arrives ALONG a rod and into
    printed plas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
2026-09-11 Make the splice a ferrule, the way a tent pole joins
    V1 was the crossing clamp's architecture copied into a joint that does not
    need it. The clamp has bolts standing beside the rod because two rods cross
    there and nothing can sit on the axis; a splice has one rod. The copy came
    out 48.4 mm wide on a 10 mm rod -- 78.8 cm3 and four M5 bolts each, which is
    3.54 litres of plastic and 180 bolts per dome.
    A splice is the one joint here that never has to close around anything,
    because it joins two SECTIONS and before assembly those are two separate
    objects. So they slide in from the ends: a plain tube, 16.4 cm3, Ø18.4, held
    by a cross pin at each end and no bolts at all. 0.74 litres per dome.
    St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
2026-09-11 Stand the stakes in the hub's slot, and mostly out of the ground
    Two things were wrong with the driven angle in the scene, and the second is
    the one that mattered.
    It was drawn entirely below ground, running from the base point straight
    down. Nothing about the design says that: the hub's slot is a THROUGH slot
    precisely so the angle can be driven to whatever depth the ground gives and
    the hub then dropped on to find its own height. An angle flush with the
    surface has nothing to drop onto. It now stands two thirds proud, which
    leaves 167 mm in the soil -- a choice, not a result, and the scene says so.
    And it stood on the base point, which is not where the slot is. The hub
    carries its slot U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
2026-09-12 Let a variant be named in any case
    `make fitted V=d6` stopped working when the Makefile started asking the model
    to turn what was typed into the name the files are filed under. It used to
    lowercase the string itself, which needed no lookup; resolve() is
    case-sensitive, so the shell helper raised and the target died -- after the
    model had already been written, which makes it look like the build broke
    rather than the argument.
    Case now folds on both the canonical name and the alias, so d6, D6, m and M
    are the same dome. An unknown name still fails loudly and still lists what it
    knows; that was the reason resolve() refuses rather than guesses, and it is
    untouched.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
2026-09-12 Size the fastener from the rod instead of always using M5
    Every connector carried an M5 set as a constant, whatever rod it was drawn
    around, and the parts were sized by the bolt rather than by the member they
    hold. Measured across the family, a two-rod clamp came out 8.1 times the rod
    at 6 mm and 3.8 times at 16 mm -- the same part in absolute terms wrapped
    round rods differing by nearly three. The base hub was deafer still: 113 mm
    across at every diameter from 6 to 16.
    The bolt is now half the rod, snapped to the nearest of M3/M4/M5/M6/M8, with
    the wall (0.4 of the rod, floored at 3 mm) and the cross pin following it.
    Print fits stay absolute, because a tolerance is not a proportion. Zero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
2026-09-12 Cut the cover to the weave, not to the drawing convention
    The fabric was being sized off `layered`, which gives each of the 15 bows its
    own shell and spreads them across fourteen rod diameters. The dome is built
    on a weave that spans three: a four-rod stack is three diameters tall, so the
    rod on the outside of it sits 1.5 off its great circle and the fabric clears
    that rod's surface half a diameter further. r + 2d, a closed form, no solver.
    On M that is r = 3020 against the 3075 this has been quoting, and 54.71 m2
    against 56.82 -- 3.7% too much fabric, cut into a cover that then has 3.7%
    too much of itself to flog. A cover can be too big as easily as too small and
    only one of those is obvio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
2026-09-12 Hang the cover on the stakes the dome already stands on
    Milestone 5 asks for a cover attachment that does not concentrate load on one
    printed part. The answer is not a better lug: it is no lug. The driven angle
    at each foot is the one thing in the structure whose whole job is resisting
    uplift through soil, and the cover's job is the same job -- so the cover goes
    on that, and nothing new gets printed.
    A bolt rope in a hem rather than eyelets, because fabric tears from a point
    and does not tear from a line. Ten loops, one per foot. And five straps over
    the crown, which is where the geometry does the work: every bow runs foot to
    foot, so a strap laid along one needs no anchor of its own.
    The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
2026-09-12 Cut the cover like this dome, or like a sphere, and write down both
    Going back to the reference turned up a cover cut this project did not have:
    6 pentagons and 10 triangles, all of side s. That is an icosidodecahedron
    hemisphere, and the dome contains it exactly -- the ten feet and the ten
    lashed nodes are its twenty vertices, its edge is the base chord R/phi, and
    25 of its 35 edges lie along the G bows. The other ten are the base ring,
    where there is no rod and no second panel: that edge is the hem.
    So the seams can land on members and the panel corners on the base hub and
    the four-rod fan, which are the two strongest points in the structure. Gores
    land on nothing, and bring all 13 seams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
2026-09-12 Split the rod a channel must clear from the rod a bolt is sized for
    The fibreglass rod this is most likely to be built from in Russia is
    composite rebar, and it is named by its EQUIVALENT diameter -- the one its
    cross-section area gives -- while carrying a winding that stands proud of
    that. A channel cut to the name does not admit the rod.
    So the one number that was doing two jobs is two. `rod_diameter` stays the
    rod as a structural member: what the fastener is sized from, what the splice
    sleeve is ten of, what bending is judged against. `rod_outer_diameter` is the
    rod as an object that has to fit: channels, rod-on-rod contact at a node, the
    weave's radial spacing, the doorway envelope, and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
2026-09-12 Measure the span that governs, and the ceiling it puts on the family
    Milestone 7 lists eight candidate reinforcements and nine criteria. They are
    not comparable until one question is answered first: what does a candidate do
    to the longest unsupported span. This measures that span, and finds that it
    sets a size ceiling the topology alone never shows.
    A bow is held at some points and free between them, and which points count is
    a decision nobody has made -- ten of the forty crossing points are lashed
    junctions, the other thirty are rod-on-rod contacts that may never get a part.
    Both readings are reported, because the gap between them is the decision:
    held at feet and tie marks 60 deg, o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
2026-09-12 Let a dome have more than one door, and say which way each faces
    Which way a door faces is a fact about where the dome is pitched -- at the
    yard, at the corridor to the next dome -- and how many it has is a fact about
    what it is for. Neither is geometry, and the geometry was choosing both. A
    camp of three domes with one automatically-placed door each cannot be laid out
    at all.
    So a variant carries an array of doors instead of one setting the whole dome
    shares:
    [[variants.D10.doors]]
    cut = "portal"
    facing = 18
    [[variants.D10.doors]]
    cut = "none"
    facing = 198
    template = "tall"
    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
2026-09-12 Make the skirt post the stake, and put the skirt's own members on a collar
    The skirted base point was read as eight members -- three bow ends, the post
    head, two ring chords and two brace heads -- which made the busiest joint in
    the structure the one place nothing was designed for, and put three part types
    in the schedule with nothing at all behind them.
    It is three members. base_hub_v1 already carries a through slot for a driven
    steel angle and two bolts across it, and a skirt post is that same angle,
    longer: driven at the bottom, standing in the slot at the top. So the post is
    no more a member of that joint than a stake is, and a skirted dome takes the
    SAME BASE3 hub a bare one takes. A p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
2026-09-12 Give every kind of joint its own close-up
    A whole-dome view shows that connectors are there; it cannot show whether they
    are on the rods. There were three close-ups for that -- a lashed node, a free
    crossing and a foot -- and they were a hand-written list, so the splice, the
    termination, the stake and the new skirt collar had none.
    The cameras now come off the schedule: one per KIND of part actually placed,
    aimed at the first placement of its kind. The three named views stay as they
    were; everything else is found. A joint that gets a generator gets a picture
    without anyone remembering to add one.
    d4_node d4_crossing d4_foot
    d4_rod_splice d4_cut_termination d4_ground_stake d4_s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
2026-09-12 Count what one dome is made of, in one place
    Every module here counts what it needs to answer its own question: the
    schedule counts connectors, the cover counts fabric, the attachment counts
    webbing, the report counts rod. Nobody had added them up. The dome was
    thoroughly measured as a shape and had never once been measured as a quantity
    -- no parts list, no plastic, and no idea which part the print farm actually
    spends its time on.
    python3 -m stardome bom M make bom
    Nothing is computed twice: the list joins what the owning modules already
    report and derives no geometry of its own, so a wrong number here is a number
    that is already wrong somewhere else.
    THE PLASTIC IS MEASURED,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
2026-09-12 Put the covers and the connectors on the camp
    The camp scene drew a frame, a skirt and a door and nothing else. Everything
    the last few changes produced -- the cover cut to the weave, the skirt collar,
    the parts themselves -- was invisible in it by construction, so the one picture
    of the project as a whole showed the least of it.
    Two flags on build_site.py:
    `--cover` drapes each dome in its fabric as ONE surface. No seams and no hem:
    the single-dome scene draws those because there the question is how the cover
    is cut and held, and here the question is what a camp looks like, which is the
    same bargain a corridor's skin already makes. Thinner than the single-dome
    scene's alpha, at 0.14 -- a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
2026-09-12 Join the domes: a camp is a plan, and it lives in its own config
    `make camp` rendered a row of one of each size. Nothing in it was joined to
    anything, so it was a size chart with an arc in it, and the name was the only
    camp-like thing about it. corridor.py has opened with "a corridor is how two
    domes become a camp rather than two tents" since the day it was written, and
    then done the half that fits inside one dome: a tunnel on a doorway, measured
    against the hole it is attached to. A corridor between two domes has two ends,
    and its length is not a parameter at all.
    configs/camps.toml says which domes stand where, how far each is turned, and
    which pairs are joined. That is all it says. The b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
2026-09-12 Let a camp build its own domes, and find the 72-degree grid the hard way
    The first real camp -- an XL hub, two L halls, two M off one hall and two S
    off one of those -- would not go together, and it failed twice for two
    different reasons worth keeping.
    ONE DOOR PER NEIGHBOUR, AND NOBODY WRITES THEM
    0018 left doors in variants.toml and had the plan report a dome short of one.
    Seven domes in, that is two doors on the hub and three on a hall, none of
    which belongs in a variant that also stands on its own elsewhere. How many
    doors a dome has and which way they point are facts about the SITE, so they
    are derived from the links and camp.prepare builds each dome accordingly.
    0018 also refused to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
2026-09-12 Close the clamp instead of tightening it, and count what that saves
    The quick-release survey started from the wrong question. Every mechanism
    worth the name -- bicycle cam skewer, over-centre toggle latch, wedge key,
    cam strap, detent pin -- answers "how do I tighten this without a tool", and
    on this part that is half the cost at most. The other half is that a
    two-piece clamp becomes three separate objects the moment it is opened, at
    head height, with both hands busy.
    So the crossing clamp gains a second closure, drawn by the same generator
    from one parameter: the cap hinged to the bottom half on a steel pin, and one
    bolt standing in a slot open to the outside instead of two in drilled hole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
2026-09-13 Bring the timber portal corridor back, and let a camp stand on it
    `813fd2a` and `05a4761` drew a second kind of corridor -- two posts, a header
    and a knee brace in each top corner, out of 45 x 145 board -- on a branch that
    diverged from main at `9619a57`. Main has since moved 72 commits and rewrote
    `camp.py` around `configs/camps.toml`, so the work never arrived. This ports
    it, and puts it where a camp can use it.
    hoop 900 x 1950 bent rod, 750 mm centres
    portal 1800 x 2100 5 boards, 1200 mm centres, 7.1 m of board per frame
    `--kind` on `corridor` and on `camp`, and a link in `camps.toml` may override
    it, so one camp can hold both. `KIND_DEFAULTS` lives in `camp.py` and now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
2026-09-13 Untwist the corridor skin, and make the pitch a distance again
    TWO BUGS, BOTH OLD, BOTH VISIBLE ONLY ONCE THE CORRIDOR WAS TIMBER
    **The skin had a half-turn in it.** Each mouth is built in its own dome's
    frame, up the +v side of the section and down the -v side. The two domes face
    each other, so one dome's +v is the other's -v in the camp -- and `_tube`
    joined the loops index for index, which pairs the left of one end with the
    right of the other. Measured on `pair`, which runs along +x: y = +450 at one
    mouth was sewn to y = -450 at the other, every quad in the strip crossing the
    corridor. Reversing the far loop pairs each point with the point on its own
    side; the worst across/up mismatch go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
2026-09-13 A camp that closes back on itself, and the parity that decides its size
    `court`: an XL hub, an L either side, two M off one L, and the two M joined
    back to each other by a chain of three S. Eight domes, eight corridors, six of
    them round an open yard, and every dome reachable two ways. 34.3 x 29.8 m,
    2.0 m of free run round the ring and 3.1-3.4 m on the joins to the hub.
    WHY THREE S AND NOT TWO
    The derived turns alternate 0 and 36 deg along a corridor, which is a
    two-colouring of the link graph -- and a graph is two-colourable only if every
    cycle in it is even. This is the project's first camp with a cycle in it. Two
    S close the ring with five corridors and one door lands 36 deg out; three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
2026-09-13 Show the project to people: one page that builds itself from the model
    Every other document here is written for whoever is working on the dome. This
    one is for whoever is being shown it -- the range, the parts and where each one
    sits, the two ways to cut the cover, and the tables -- and it is the first
    thing in the repo written in Russian, because that is who reads it.
    It is generated rather than written. `extract.py` takes one snapshot of the
    model, `draw.py` draws from that snapshot, and `build.py` fills the holes in
    `template.html`, so a change in variants.toml reaches the presentation by
    rebuilding it instead of by remembering to. Nothing on the page is a number
    someone typed.
    The draw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
2026-09-13 Name D12 XXL, and say plainly what a name does and does not mean
    D12 has carried `door = "carry"` and `door_cut = "portal"` since the portal
    landed, and no skirt, which is the same settled build M, L and XL have. What
    it lacked was a short name, on the grounds that it is an end of the range kept
    for study. That reasoning fits D3, whose 1473 mm of dome is not standing
    height and whose skirt is dominated by S (decision 0009). It does not fit D12,
    which admits every silhouette in the table with 3636 mm of clear opening.
    So: `alias = "XXL"`. Five named sizes, and `--named-only`, `make sizes` and
    the README table follow.
    WHAT A NAME MEANS HERE
    An alias says the BUILD is chosen -- skirt settled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
    [variants.scad]
2026-09-13 The leaf cut: stop paying the 2/pi tax on every gore
    A gore fills exactly 2/pi of its own bounding rectangle -- at any radius, at
    any count -- and nesting cannot recover the taper, because at the equator the
    gore is already the full strip width. That is a third of the roll, gone, and
    the cover module had no answer to it.
    A leaf is a gore that has given up crossing the roll in one piece. Its lanes
    run ALONG the roll instead of across it, so the roll width caps nothing; the
    lanes are near-trapezoids, so turning every other one end for end lets two
    share a rectangle and a lane costs its mean width rather than its widest.
    That is 17-32% of the fabric back, at every size in the family.
    The hori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
2026-09-13 Give the rod a modulus, the dome a wind, and the line a verdict
    docs/span.md ends by saying what it is not: "There is no modulus, no strength
    and no load anywhere in it." configs/variants.toml says the same about its own
    rod diameters -- "engineering assumptions, not results". This supplies all
    three, for D3 through D12.
    Three new inputs, each its own config so a number can be argued with without
    touching code, and every value carrying the standard it came from:
    materials.toml (three candidate stocks, reference is GOST 31938 minima),
    loads.toml (wind only -- the dome comes down before winter), and the checks
    themselves in stardome/{material,loads,strength}.py.
    What it found, in the order i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
2026-09-13 Walk through the camp instead of looking at it
    `--walk` on build_site.py. Three changes that are each useless without the
    other two, which is why it is one flag and not three:
    the covers go opaque at 0.14 alpha a camp is a diagram, and from
    the inside it is not a room at all
    a lamp inside every dome an opaque dome under sunlight is a black hole
    and every corridor from within. 16 lamps in the court camp
    the camera becomes an eye 1.7 m up, 24 mm lens, 50 mm near clip, standing
    clear of the camp and looking back at it
    Blender does the walking -- Numpad 0, then Shift+` for Walk Navigation. The
    one thing th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
2026-09-13 Cut the cover open where something goes through it
    The corridors were porches and the doors were painted on. A cover is a closed
    shell of revolution: no doorway, no hole where a tunnel lands. It never showed
    while the fabric was see-through, and it is the whole thing from inside -- a
    camp that looks joined was eight sealed domes with tubes leaning on them.
    Every opening is taken out of the cover now, both kinds by one mechanism: a
    plug swept along the axis of whatever is meant to pass through, differenced
    away. On `court` that is 16 corridor mouths and 17 doorways.
    THE COVER NEEDED THICKNESS FIRST, AND THAT IS NOT DECORATION
    The exact boolean solver decides what is inside a target by wind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
2026-09-13 Add the cut list: where each bow is actually sawn
    The page counted sections and drew the splices on the dome, but never said
    where to put the saw. This adds the sheet that does, and it is the one a
    person stands at a bench with.
    A bow is bent, so where it gets cut is an arc length -- and arc length is a
    straight line once the bow is unrolled. That is the frame the drawing uses,
    and it is the frame the two rules are naturally stated in: no section longer
    than the transport limit, no joint within a sleeve of a crossing. The drawing
    shows the crossings, the keep-out band around each, and where the cuts
    actually landed, for the typical bow of each named size at one common scale.
    What it turned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
2026-09-13 Seal the corridor joint, and stop the fabric swallowing the frame
    TWO CUTS WHERE ONE WAS WANTED
    A door and the corridor that lands on it were being cut out of the cover
    separately, and the bay is the wider of the two -- 3.0 m of clear opening
    against an 1800 mm portal on XL. The difference came out as a slot of daylight
    all round the tunnel, cover taken away with nothing put back in its place.
    So a door with a corridor on it is opened to the TUNNEL'S mouth and nothing
    else; the tunnel is then what seals it. Only a door carrying no corridor is
    cut to its own outline, which on `court` is the one the hub was given to get
    in by: 16 mouths and 1 doorway, against 16 and 17 before.
    Measured rath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
2026-09-13 A shopping list for one S, with its cut tally
    The deck could say what a dome is made of per size, but nobody can take that
    to a shop. This is the sheet you can: everything for one S in one place,
    grouped by what you do with it -- buy, cut, print.
    S is the size worth writing it for. It is the only named one with a skirt, so
    its list carries what the others do not -- posts, rings, braces and twenty
    collars -- and it is the smallest thing anyone would actually build first.
    Its parts had never been generated, so the plastic column was empty; built
    them, and the D6 finding repeats and gets worse on the way down. BASE3 and
    BASE2 are 3162 cm3 of 5318, 59% of the plastic, on a dome whose rod is 8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
2026-09-13 Turn the lamps down, and get them out of the walker's eyes
    14 W per square metre of floor is a floodlit hangar: the fabric blew out white
    and the frame stopped reading against it, which is the one thing an opaque
    dome is lit for. 3 W/m2 instead -- 236 W in XL against 1100 -- and the cover
    comes back to a grey the rods read against.
    It is a dial rather than a constant now. `--lamp-gain` scales the lot, because
    what a fabric dome at dusk looks like is a taste and not a measurement, and
    guessing it once for everybody is how a number like 14 gets in.
    The corridor lamps hung at 1.7 m, which is exactly where the walker's eyes
    are. They go 300 mm under the tunnel roof, where a lamp in a tunnel go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
2026-09-13 Cut the whole dome from two lengths, not from four
    A bow was divided evenly and every joint that landed on a crossing was
    nudged the shortest distance that cleared it. Per bow that is the best
    answer available. Dome-wide it produced four cut lengths on S, four on
    L and seven on D12 -- 2094 and 2014 among them, 80 mm apart over two
    metres, two parts nobody can tell apart in a bag on wet grass.
    The kit is now solved once for the dome. Choosing how many pieces of
    each length two stretches are made of gives two equations in the two
    lengths and fixes them exactly; each candidate is laid against every
    stretch with its joints checked against every crossing, and of the kits
    that survive the one tha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
2026-09-13 Say two lengths on the page, and show which is which
    The deck was written against the old rascroy and now contradicts it: the
    cut sheet explained a nudge that no longer happens, the size table
    listed longest-section and "деление" columns that stopped meaning
    anything, and the S shopping list promised 45 sections in four lengths.
    The sheet now states the third rule alongside the other two, and the
    size table carries the cut list itself -- 2314 / 1655, 2356 / 1862 --
    instead of the longest section and how the division went. The drawing
    tints the shorter of a dome's two lengths rather than annotating how far
    each joint moved off the even division, which is no longer the
    mechanism; the e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
2026-09-13 Meet the angle on a pad, and make every nut in the hub captive
    Two things were wrong with the base hub, and both are about what holds
    it rather than what it holds.
    The driven steel angle went through an L-section slot cut clean across
    the base plate. A plate is one thickness, so the slot's 31 mm band and
    the floor under it were added to all 104 x 113 mm of that plate: 258 cm3
    of a 431 cm3 hub, and 2643 mm2 of flat slot roof at 0 deg of overhang --
    the worst face in the kit and item 4 of the roadmap's list. The angle
    now lies against a 38 x 45 mm pad on the outside of the bottom plate
    with one bolt through both. It still passes the hub and still stands
    proud for the cover's loops; it passes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
2026-09-13 Hold the angle with a bought loop, not with a hole drilled in it
    Two things came back from the field reading of the pad: it only touches
    one face of the angle, and a bolt through a drilled hole assumes the
    angle stopped where you wanted it to. Dry ground does not work like
    that -- an angle stops where it stops, and a row of holes fine enough
    to always have one in the right place is a row that has taken the
    section out of the steel.
    So the fastening is a U-bolt: both legs up through the pad, a nut and a
    washer on each, the loop round the whole section. Nothing is drilled.
    what holds it one M8 through a drilled hole -> a loop round it
    the angle needs a row of holes at 20 mm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
2026-09-13 Close the angle in with a wrap, and let the pad keep its two bolts
    The loop held the section and stood off it on a round rod. What was
    wanted was something that lies ON the angle, so the fourth side of the
    joint is now a fifth printed piece: a shallow box that takes the
    standing leg's inner face, both its edges, and -- through a relief at
    each end -- the root of the leg that stands out of the section. Three
    sides from the wrap, the fourth from the pad, and the steel is touched
    on all four.
    Why it is a separate piece and not a lip on the plate: the angle lies
    against the face the bottom plate is PRINTED on, so anything reaching
    round it would hang below the bed. That is what produced the fla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
2026-09-13 Lay the pieces out the way they are printed, and say what fits
    `make clamps` exports every piece in the frame the part is DESIGNED in,
    which is the right frame for putting a connector on a dome and the wrong
    one for putting it on a bed. Two things a slicer needs were missing from
    it and both are known here: which face each piece sits on, and whether
    the set fits the machine at all.
    make prints V=S BED=220x220 -> exports/print/d4/
    Each piece comes out turned onto the face it prints on and dropped so
    that face is z = 0, and again packed onto beds. In the slicer: place, do
    not rotate. Which pieces print the other way up is no longer a literal
    in two places -- base_hub_v1 exports FLIPP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
2026-10-03 Print a dome as Bambu Studio projects, plates already laid out
    make prints now writes one .3mf with every printed piece of the dome at its
    count, arranged onto plates by Bambu Studio's own command line, plus one .3mf
    per part for a fit check. It covers every generated connector, not just the
    base hub, and replaces the bed STLs that a slicer read as one object each.
    Each generator declares FLIPPED_PIECES; make clamps writes them into a print
    manifest that tools/print_plates.py turns and arranges from. See decision 0030.
2026-10-08 Seat the base hub on rebar with a vee cradle that takes any bar
    The stake is driven steel rebar now, not an angle. The wrap round the angle
    is replaced by a cradle: a 90 deg vee on the same two M8 bolts through the
    same pad. A round bar touches both flanks at any size, so one cradle clamps
    every bar from 8 to 18 mm across the ribs, and the rim never lands on the pad.
    The bottom plate is unchanged -- a BASE3-8 set is already printed. Both
    BASE3-8 and BASE2-8 bottoms compare to the old solids at 0.0 mm3 each way.
    Decision 0031. Also records the first BASE3-8 fit result: 10 mm composite
    rebar enters the rod channel and 8 mm rattles; not corrected yet.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
2026-10-08 Number the base hub's versions: 1.0 for the angle, 1.1 for rebar
    Records that the printed BASE3-8 takes 10 mm composite rebar, and what the
    fit check taught for 2.0.
2026-10-08 Print the base hub in one piece: base hub 2.0
    A tube per bow at the 1.x levels, each on a rib that flares in at 50 deg,
    channels open behind the centre, and an 80 mm sleeve under the fan whose vee
    roof two M8 set bolts push the rebar into. One print, no supports, no stack
    bolts. BASE3-8 is 98 cm3 against 1.1's 222; a dome is 169 prints, not 207.
    The channel is Ø9.4, the printed 1.x fit that takes a 10 mm composite rebar.
    Every slope is 50 deg: faces drawn at exactly 45 passed or failed the overhang
    check on rounding.
    The schedule now builds base_hub_v2; base_hub_v1 stays as 1.1. Decision 0032.
2026-10-08 Thin the base hub's ribs to 1.6 mm
    At 1.5 walls the ribs were a quarter of the hub. BASE3-8 goes from 97.5 to
    80.6 cm3, BASE3-10 from 121 to 98; the overhang check stays clean.
2026-10-08 Add base hub 2.0b: the same hub with no ribs, for slicer supports
    ribs = 0 leaves each tube bare. BASE3-8 is 69 cm3 against 2.0's 81, at the
    price of supports to break off and no rib stiffening the arm. Both are to be
    printed and compared.
2026-10-21 Make Bambu Studio keep the projects' walls and infill
    The projects carried wall_loops, sparse_infill_density and enable_support
    but left different_settings_to_system empty, so Studio took the process for
    an unmodified system preset and loaded 0.20mm Standard's own values over
    them. List the overridden keys there.
2026-10-28 Give the base hub a mirror image instead of turning it over
    The second mirror set of feet used to take the hub turned over, which puts
    the rebar sleeve on the dome side at five feet and the outside at the other
    five. They now take BASE3-8m / BASE2-8m, the hub with every arm at 180 deg
    minus its azimuth. The placement reports a hand, and nothing is turned over.
    Decision 0033.
